ollewelin/delta_robot/README.md

3x3 Motor dirver board for a delta robot
Open Source

## 3x3Motor V2.0 with Efinix T20 FPGA 2 CSI camera ports and 8ch 12bit ADC with current shunt OP amplifier

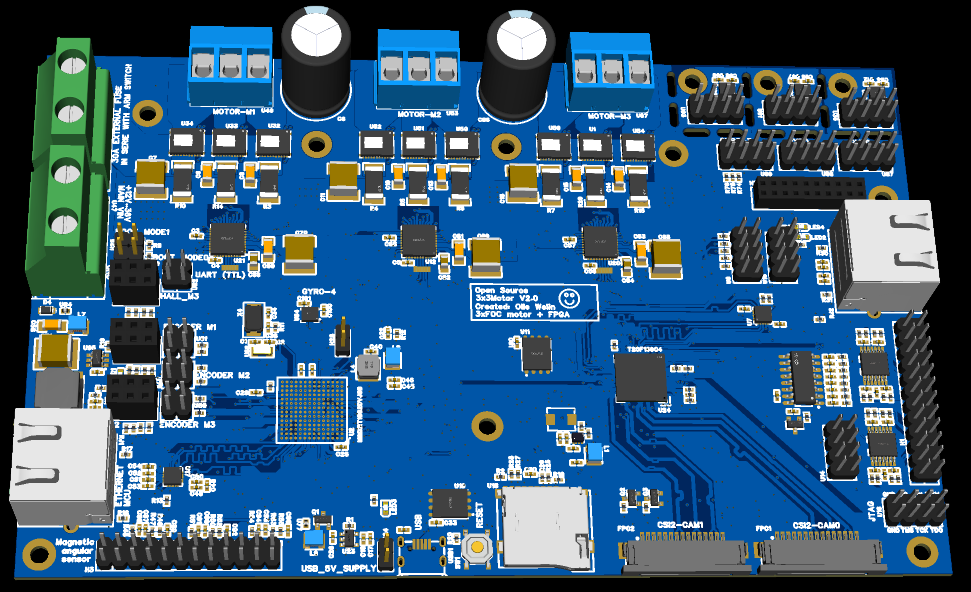
[picture p1: 3x3Motor_V2.0_FPGA_T20.png]


## 3x3Motor V1.0

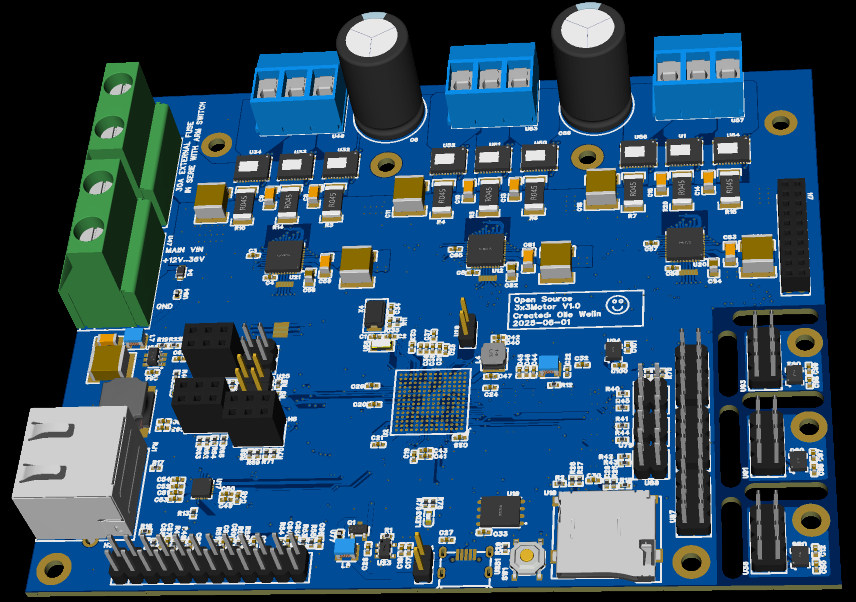
[picture p2: PCB_draft2.png]


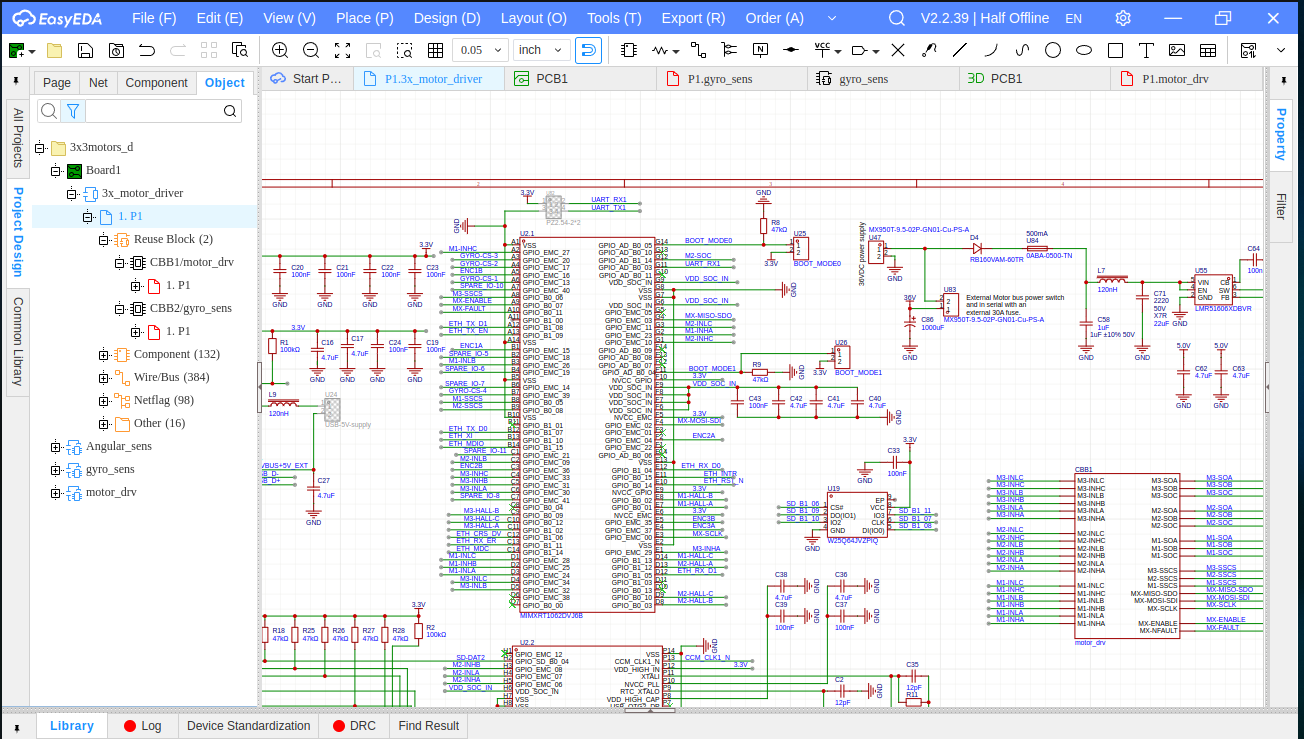
[picture p3: PCB_draft2_EasyEDA.png]
