ollewelin/delta_robot/Screenshot from 2025-05-25 20-46-30.png

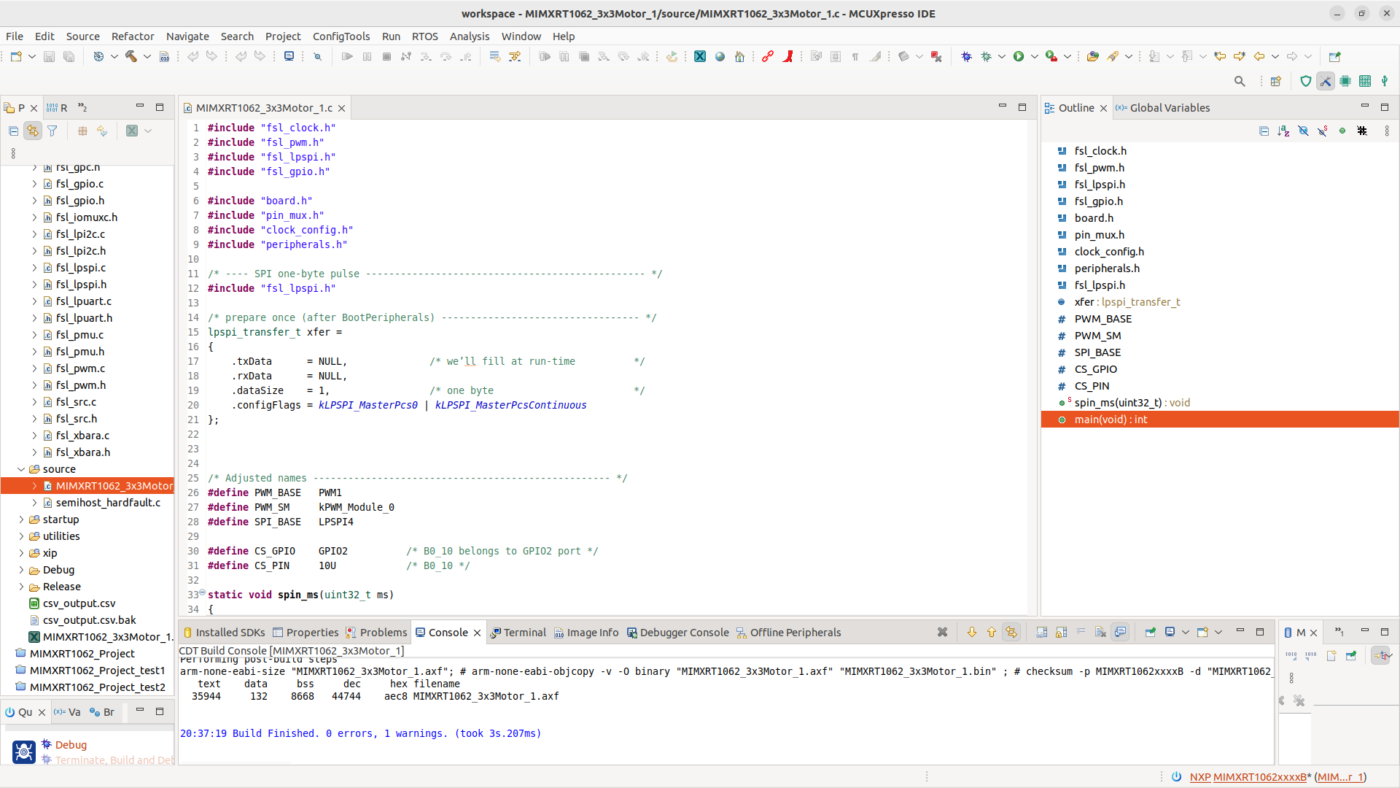
Screenshot from 2025-05-25 20-46-30.png
