ollewelin/delta_robot/Screenshot from 2025-05-25 20-46-59.png

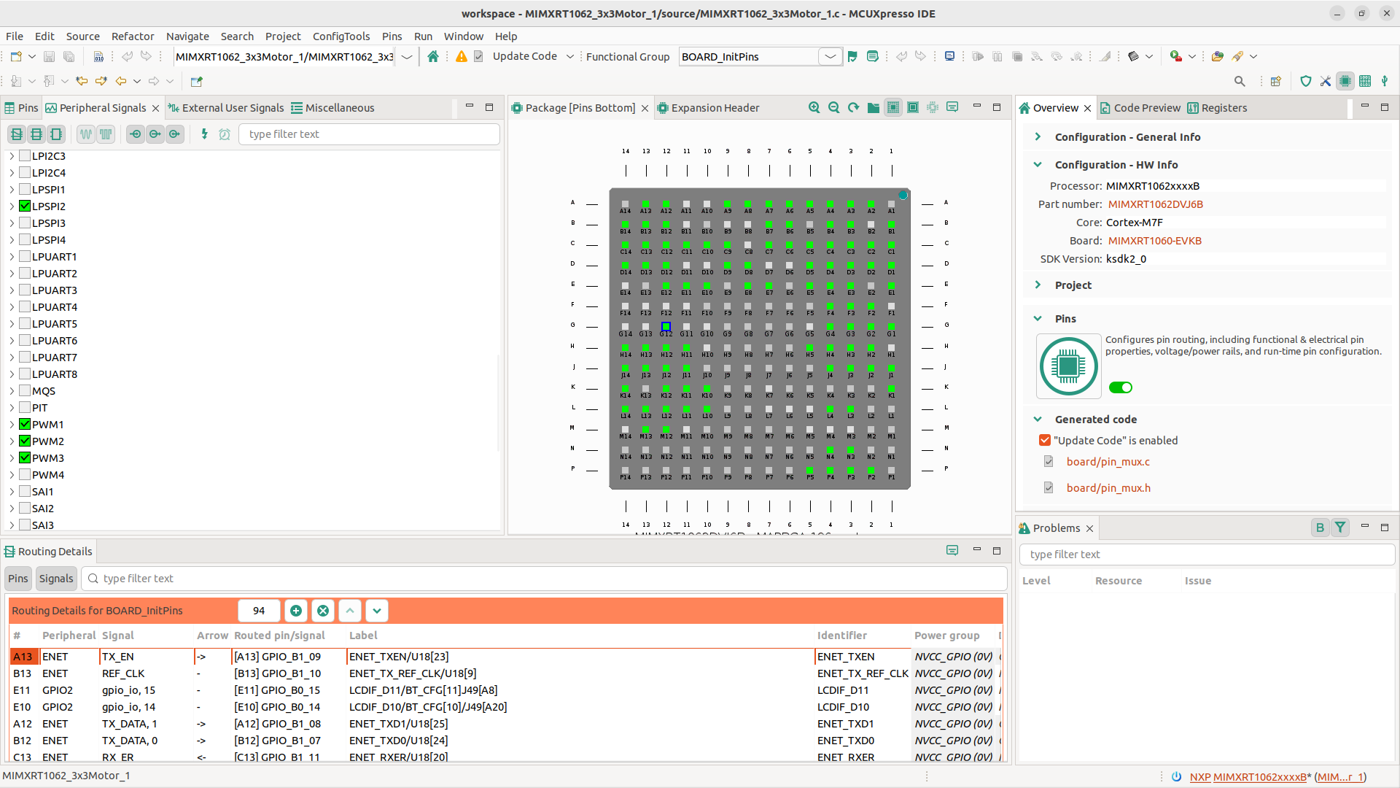
Screenshot from 2025-05-25 20-46-59.png
