ollewelin/delta_robot/V2.0_PCBA_manufacture_export/BOM_Board1_PCB1_2025-06-28_manuel_adjusted.xlsx

No. | Quantity | Comment | Designator | Footprint | Value | Manufacturer Part | Manufacturer | Supplier Part | Supplier
1 | 6 | 12pF | C1,C2,C34,C35,C109,C110 | C0402 | 12pF | V120J0402HQC500NBT | VIIYONG(微容) | C5251212 | LCSC
2 | 68 | 100nF | C3,C19,C20,C21,C22,C23,C24,C25,C26,C28,C30,C31,C32,C33,C37,C39,C43,C47,C50,C55,C57,C61,C64,C73,C74,C76,C78,C80,C85,C96,C100,C104,C111,C112,C113,C114,C116,C117,C118,C119,C120,C121,C122,C123,C124,C125,C126,C127,C128,C129,C130,C131,C133,C134,C137,C139,C141,C142,C143,C144,C145,C146,C148,C149,C150,C151,C152,C153 | C0402 | 100nF | CL05B104KB54PNC | SAMSUNG(三星) | C307331 | LCSC
3 | 38 | 4.7uF | C4,C5,C12,C16,C17,C27,C29,C36,C38,C40,C41,C42,C44,C45,C46,C48,C49,C56,C60,C62,C63,C65,C67,C72,C75,C77,C79,C97,C101,C102,C103,C115,C132,C135,C136,C138,C140,C147 | C0402 | 4.7uF | LMK105BBJ475MVLF | TAIYO YUDEN(太诱) | C386043 | LCSC
4 | 2 | 1000uF | C6,C86 | CAP-TH_BD13.0-P5.00-D0.6-FD | 1000uF | 50V1000uF CD288 | HRK(鸿瑞凯电子) | C2960425 | LCSC
5 | 7 | 22uF | C7,C11,C18,C68,C69,C70,C71 | C2220 | 22uF | FS55X226K500EHG | PSA(信昌电陶) | C784103 | LCSC
6 | 10 | 1uF | C8,C9,C10,C13,C14,C15,C58,C59,C81,C83 | C1206 | 1uF | CL31B105KBHNNNE | SAMSUNG(三星) | C1848 | LCSC
7 | 8 | 33nF | C51,C52,C53,C54,C105,C106,C107,C108 | C0402 | 33nF | 0402B333K160CT | Walsin(华新科) | C301939 | LCSC
8 | 3 | 22nF | C66,C82,C84 | C0805 | 22nF | CL21B223KBANNNC | SAMSUNG(三星) | C1729 | LCSC
9 | 9 | 4.7nF | C87,C88,C89,C90,C91,C92,C93,C94,C95 | C0402 | 4.7nF | 0402B472K500NT | FH(风华) | C1538 | LCSC
10 | 1 | RB160VAM-60TR | D4 | TUMD2M_L2.0-W1.4-LS2.5-RD |  | RB160VAM-60TR | ROHM(罗姆) | C600653 | LCSC
11 | 2 | 52271-1569 | FPC1,FPC2 | FFC-SMD_15P-P1.00_522711569 |  | 52271-1569 | MOLEX | C588183 | LCSC
12 | 1 | HX PZ2.54-2x12P ZZ | H1 | HDR-TH_24P-P2.54-V-M-R2-C12-S2.54 |  | HX PZ2.54-2x12P ZZ | hanxia(韩下) | C42372520 | LCSC
13 | 3 | 排母/2.54mm2x3直排母袋装环保 | H4,H5,H6 | HDR-TH_6P-P2.54-V-F-R2-C3-S2.54 |  | 排母/2.54mm2x3直排母袋装环保 |  | C47552 | LCSC
14 | 1 | 2.0-210-SMT-Pin | H7 | HDR-TH_20P-P2.00-V-F-R2-C10-S2.00 |  | 2.0-210-SMT-Pin |  | C9900188734 | LCSC
15 | 4 | PZ254-1-02-Z-8.5 | H24,H25,H26,H28 | HDR-TH_2P-P2.54-V-M |  | PZ254-1-02-Z-8.5 | HCTL(华灿天禄) | C2894925 | LCSC
16 | 4 | 120nH | L1,L7,L8,L9 | IND-SMD_L2.9-W2.5 | 120nH | LSF1008-R12J-T | EMTEK(兆欣) | C252036 | LCSC
17 | 1 | 4.7uH | L4 | IND-SMD_L4.0-W4.0 | 4.7uH | SNR4018-4R7MT | LanTu Micro(蓝图微电) | C5127371 | LCSC
18 | 1 | 33uH | L11 | IND-SMD_L8.0-W8.0 | 33uH | NRS8030T330MJGJ | TAIYO YUDEN(太诱) | C223028 | LCSC
19 | 4 | KT-0603R | LED1,LED2,LED3,LED4 | LED0603-RD |  | KT-0603R | KENTO | C2286 | LCSC
20 | 1 | DMG2305UX-7 | Q1 | SOT-23-3_L2.9-W1.3-P1.90-LS2.4-BR |  | DMG2305UX-7 | HXY MOSFET(华轩阳电子) | C5261054 | LCSC
21 | 2 | BSS138 | Q2,Q3 | SOT-23-3_L2.9-W1.3-P1.90-LS2.4-BR-1 |  | BSS138 | KUU | C3015220 | LCSC
22 | 3 | 100kΩ | R1,R2,R21 | R0402 | 100kΩ | FRC0402F1003TS | FOJAN(富捷) | C2906859 | LCSC
23 | 9 | 20mΩ | R3,R4,R5,R6,R7,R10,R14,R15,R20 | RES-SMD_L6.4-W3.2-R2512 | 20mΩ | PA2512FKF7W0R02E | YAGEO(国巨) | C728347 | LCSC
24 | 8 | 47kΩ | R8,R9,R18,R25,R26,R27,R28,R29 | R0402 | 47kΩ | AC0402JR-0747KL | YAGEO(国巨) | C144710 | LCSC
25 | 1 | 2.2MΩ | R11 | R0402 | 2.2MΩ | FRC0402F2204TS | FOJAN(富捷) | C2998080 | LCSC
26 | 16 | 1kΩ | R12,R40,R41,R42,R43,R44,R45,R57,R59,R61,R63,R65,R67,R69,R71,R73 | R0402 | 1kΩ | 0402WGF1001TCE | UNI-ROYAL(厚声) | C11702 | LCSC
27 | 2 | 6.49kΩ | R13,R24 | R0402 | 6.49kΩ | RT0402BRE076K49L | YAGEO(国巨) | C853380 | LCSC
28 | 4 | 150Ω | R16,R17,R30,R31 | R0402 | 150Ω | 0402WGF1500TCE | UNI-ROYAL(厚声) | C25082 | LCSC
29 | 1 | 20kΩ | R19 | R0402 | 20kΩ | 0402WGJ0203TCE | UNI-ROYAL(厚声) | C25545 | LCSC
30 | 34 | 4.7kΩ | R22,R23,R35,R36,R37,R38,R39,R46,R47,R48,R49,R50,R51,R52,R53,R54,R55,R56,R58,R60,R62,R64,R66,R68,R70,R72,R74,R75,R76,R83,R84,R85,R86,R88 | R0402 | 4.7kΩ | 0402WGF4701TCE | UNI-ROYAL(厚声) | C25900 | LCSC
31 | 21 | 470Ω | R33,R89,R90,R95,R96,R97,R98,R99,R100,R101,R102,R103,R104,R105,R106,R107,R108,R109,R110,R111,R119 | R0402 | 470Ω | 0402WGF4700TCE | UNI-ROYAL(厚声) | C25117 | LCSC
32 | 8 | 150Ω | R34,R112,R113,R114,R115,R116,R117,R118 | R0402 | 150Ω | CRCW0402150RFKED | VISHAY(威世) | C82683 | LCSC
33 | 13 | 22Ω | R77,R78,R80,R81,R91,R120,R121,R122,R123,R124,R125,R126,R127 | R0402 | 22Ω | ERJU02J220X | PANASONIC(松下) | C417075 | LCSC
34 | 3 | 10kΩ | R79,R82,R87 | R0402 | 10kΩ | 0402WGF1002TCE | UNI-ROYAL(厚声) | C25744 | LCSC
35 | 2 | RJHSE5384 | RJ1,RJ2 | RJ45-TH_RJHSE5384 |  | RJHSE5384 | Amphenol | C464587 | LCSC
36 | 1 | TS-1187A-B-A-B | SW1 | SW-SMD_4P-L5.1-W5.1-P3.70-LS6.5-TL_H1.5 |  | TS-1187A-B-A-B | XKB Connectivity(中国星坤) | C318884 | LCSC
37 | 9 | CSD88599Q5DC | U1,U32,U33,U34,U50,U51,U52,U54,U56 | SON-22_L5.0-W6.0-P0.50-CSD88599Q5DCT |  | CSD88599Q5DC | TI(德州仪器) | C2871380 | LCSC
38 | 1 | MIMXRT1062DVJ6B | U2 | LFBGA-196_L12.0-W12.0-R14-C14-P0.80-BL |  | MIMXRT1062DVJ6B | NXP(恩智浦) | C3216699 | LCSC
39 | 2 | INA4180A3QPWRQ1 | U3,U25 | TSSOP-14_L5.0-W4.4-P0.65-LS6.4-BL |  | INA4180A3QPWRQ1 | TI(德州仪器) | C2866762 | LCSC
40 | 1 | LM4040EEM3-2.5/NOPB | U4 | SOT-23-3_L2.9-W1.3-P1.90-LS2.4-BR |  | LM4040EEM3-2.5/NOPB | TI(德州仪器) | C205908 | LCSC
41 | 1 | MCP3208T-CI/SL | U5 | SOIC-16_L9.9-W3.9-P1.27-LS6.0-BL |  | MCP3208T-CI/SL | MICROCHIP(美国微芯) | C626764 | LCSC
42 | 9 | PZ2.54-2*4 | U6,U14,U15,U16,U35,U87,U88,U89,U91 | HDR-TH_8P-P2.54-V-M-R2-C4-S2.54 |  | PZ2.54-2*4 | ZHOURI(洲日) | C5156676 | LCSC
43 | 2 | DP83825IRMQR | U7,U17 | HVQFN-24_L3.0-W3.0-P0.40-TL-EP1.9 |  | DP83825IRMQR | TI(德州仪器) | C783599 | LCSC
44 | 1 | TPS62840DLCR | U9 | VSON-8_L2.0-W1.5-P0.50-BL |  | TPS62840DLCR | TI(德州仪器) | C2071859 | LCSC
45 | 1 | 2.2uH | U10 | IND-SMD_L4.7-W4.2 | 2.2uH | CYA0420-2.2UH | SHOU HAN(首韩) | C19274348 | LCSC
46 | 2 | W25Q64JVZPIQ | U11,U19 | WSON-8_L6.0-W5.0-P1.27-BL-EP |  | W25Q64JVZPIQ | WINBOND(华邦) | C2940197 | LCSC
47 | 3 | DRV8304SRHAR | U12,U20,U21 | VQFN-40_L6.0-W6.0-P0.50-TL-EP |  | DRV8304SRHAR | TI(德州仪器) | C1849480 | LCSC
48 | 1 | PCA9306DC1 | U13 | VSSOP-8_L2.4-W2.1-P0.50-LS3.2-BR |  | PCA9306DC1 | NXP(恩智浦) | C129510 | LCSC
49 | 1 | A-MicroTF-1.85A | U18 | TF-SMD_A-MICROTF-1.85A |  | A-MicroTF-1.85A | MyAntenna(摩天射频) | C22467599 | LCSC
50 | 1 | TLV75525PDQNR | U22 | X2SON-4_L1.0-W1.0-P0.65-TL-EP |  | TLV75525PDQNR | TI(德州仪器) | C2876066 | LCSC
51 | 1 | TLV75733PDBVR | U23 | SOT-23-5_L2.9-W1.6-P0.95-LS2.8-BL |  | TLV75733PDBVR | TI(德州仪器) | C485517 | LCSC
52 | 1 | T20F169C4 | U24 | FBGA-169_L9.0-W9.0-R13-C13-P0.65-TL |  | T20F169C4 | Efinix | C7054906 | LCSC
53 | 1 | PCA9542APW/DG118 | U26 | TSSOP-14_L4.9-W4.4-P0.65-LS6.4-BL |  | PCA9542APW/DG118 | NXP(恩智浦) | C3208518 | LCSC
54 | 1 | TLV75512PDBVR | U27 | SOT-23-5_L2.9-W1.6-P0.95-LS2.8-BR |  | TLV75512PDBVR | TI(德州仪器) | C2877864 | LCSC
55 | 1 | TLV75518PDBVR | U31 | SOT-23-5_L2.9-W1.6-P0.95-LS2.8-BR |  | TLV75518PDBVR | TI(德州仪器) | C2877863 | LCSC
56 | 2 | MX950T-9.5-02P-GN01-Cu-PS-A | U47,U83 | CONN-TH_2P-P9.50_DB910-9.52-2P |  | MX950T-9.5-02P-GN01-Cu-PS-A | MAX(迈旭) | C5188495 | LCSC
57 | 3 | KF332K-5.0-3P | U49,U53,U57 | CONN-TH_KF332K-5.0-3P |  | KF332K-5.0-3P | KEFA(科发) | C474890 | LCSC
58 | 1 | 32.768kHz | U66 | CRYSTAL-SMD_L3.2-W1.5-2 | 32.768kHz | H3100327092070CY | JGHC(晶光华) | C20625736 | LCSC
59 | 2 | 0ABA-0500-TN | U77,U84 | F0402 |  | 0ABA-0500-TN | belfuse | C3162379 | LCSC
60 | 4 | PZ2.54-2*2 | U79,U80,U81,U82 | HDR-TH_4P-P2.54-V-M-R2-C2-S2.54 |  | PZ2.54-2*2 | ZHOURI(洲日) | C5156675 | LCSC
61 | 3 | ASM330LHHTR | U86,U90,U94 | LGA-14L_L3.0-W2.5-P0.50-TL |  | ASM330LHHTR | ST(意法半导体) | C459826 | LCSC
62 | 1 | LMR51610XDBVR | U95 | SOT-23-6_L2.9-W1.6-P0.95-LS2.8-BR |  | LMR51610XDBVR | TI(德州仪器) | C20539658 | LCSC
63 | 1 | 051N-4BH806-S | USB1 | MICRO-USB-SMD_051N-4BH806-S |  | 051N-4BH806-S | HanElectricity(瀚源) | C25503148 | LCSC
64 | 1 | 25MHz | X1 | CRYSTAL-SMD_4P-L5.0-W3.2-BL | 25MHz | XC53M4-25.000-F12JJDT | HCI(杭晶) | C2916916 | LCSC
65 | 1 | 24MHz | X4 | OSC-SMD_L5.0-W3.2 | 24MHz | XSHEELNANF-24MHZ | TAITIEN(泰艺电子) | C295068 | LCSC
66 | 1 | 50MHz | X5 | OSC-SMD_4P-L3.2-W2.5-BL-OXETDLJANF-0.032768MHZ | 50MHz | 2.1.3.5000023 | MDH(明德亨) | C42420976 | LCSC
