ollewelin/delta_robot/failure_start_RAM_at_blank_MIMXRT1062/Log_test_evkbmimxrt1060_iled_blinky_iled_blinky.txt

Test the
evkbmimxrt1060_iled_blinky_iled_blinky.bin

Commands I test was this:
# Power cycle

sdphost -u 0x1fc9,0x0135 -- write-file 0x20000000 evkbmimxrt1060_iled_blinky_iled_blinky.bin
hexdump -C evkbmimxrt1060_iled_blinky_iled_blinky.bin
sdphost -u 0x1fc9,0x0135 -- read-register 0x20000000 8 13496 -h

# Manual reset

sdphost -u 0x1fc9,0x0135 -- error-status
sdphost -u 0x1fc9,0x0135 -- read-register 0x20000000
sdphost -u 0x1fc9,0x0135 -- jump-address 0x20000000
sdphost -u 0x1fc9,0x0135 -- error-status
sdphost -u 0x1fc9,0x0135 -- read-register 0x20000000 8 13496 -h

========== Log ==============
At line 1729 in this log I got this error
sdphost -u 0x1fc9,0x0135 -- error-status
Status (HAB mode) = 1450735702 (0x56787856) Hab Is Disabled (Unlocked).
Response status = 858993459 (0x33333333) NO DESCRIPTION.

(base) olle@olle-SSD-256:~/nxp_flashloader/mcu-boot-utility/tools/sdphost/linux/amd64$ sdphost -u 0x1fc9,0x0135 -- write-file 0x20000000 evkbmimxrt1060_iled_blinky_iled_blinky.bin
Status (HAB mode) = 1450735702 (0x56787856) Hab Is Disabled (Unlocked).
Response status = 2290649224 (0x88888888) Write File Success.
(base) olle@olle-SSD-256:~/nxp_flashloader/mcu-boot-utility/tools/sdphost/linux/amd64$ hexdump -C evkbmimxrt1060_iled_blinky_iled_blinky.bin
00000000  00 00 02 20 1d 03 00 20  a1 03 00 20 59 2a 00 20  |... ... ... Y*. |
00000010  a5 03 00 20 a7 03 00 20  a9 03 00 20 00 00 00 00  |... ... ... ....|
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
000034B0: 72 00 77 00 00 A4 78 1F                           r.w...x.
Status (HAB mode) = 1450735702 (0x56787856) Hab Is Disabled (Unlocked).
(base) olle@olle-SSD-256:~/nxp_flashloader/mcu-boot-utility/tools/sdphost/linux/amd64$
