ollewelin/delta_robot/V2.0_PCBA_manufacture_export/3x3Motor_V2.0_schematics.pdf

GPIO_B0_03 D8 GPIO_B0_00 D7 GPIO_EMC_38 D6 GPIO_EMC_32 D5 GPIO_EMC_34 D4 GPIO_EMC_24 D3 GPIO_EMC_25 D2 GPIO_EMC_28 D1 GPIO_B1_14 C14 GPIO_B1_11 C13 GPIO_B1_06 C12 GPIO_B1_02 C11 GPIO_B0_12 C10 GPIO_B0_09 C9 GPIO_B0_04 C8 GPIO_EMC_41 C7 GPIO_EMC_30 C6 GPIO_EMC_31 C5 GPIO_EMC_33 C4 GPIO_EMC_36 C3 GPIO_EMC_09 C2 GPIO_EMC_21 C1 GPIO_B1_15 B14 GPIO_B1_10 B13 GPIO_B1_07 B12 GPIO_B1_01 B11 VSS B10 GPIO_B0_08 B9 GPIO_B0_05 B8 GPIO_EMC_39 B7 GPIO_EMC_14 B6 VSS B5 GPIO_EMC_19 B4 GPIO_EMC_26 B3 GPIO_EMC_18 B2 GPIO_EMC_15 B1 VSS A14 GPIO_B1_09 A13 GPIO_B1_08 A12 GPIO_B1_00 A11 GPIO_B0_11 A10 GPIO_B0_07 A9 GPIO_B0_06 A8 GPIO_EMC_40 A7 GPIO_EMC_13 A6 GPIO_EMC_16 A5 GPIO_EMC_17 A4 GPIO_EMC_20 A3 GPIO_EMC_27 A2 VSS A1

# 3x3Motor V2.0 R⁴⁰ 1k

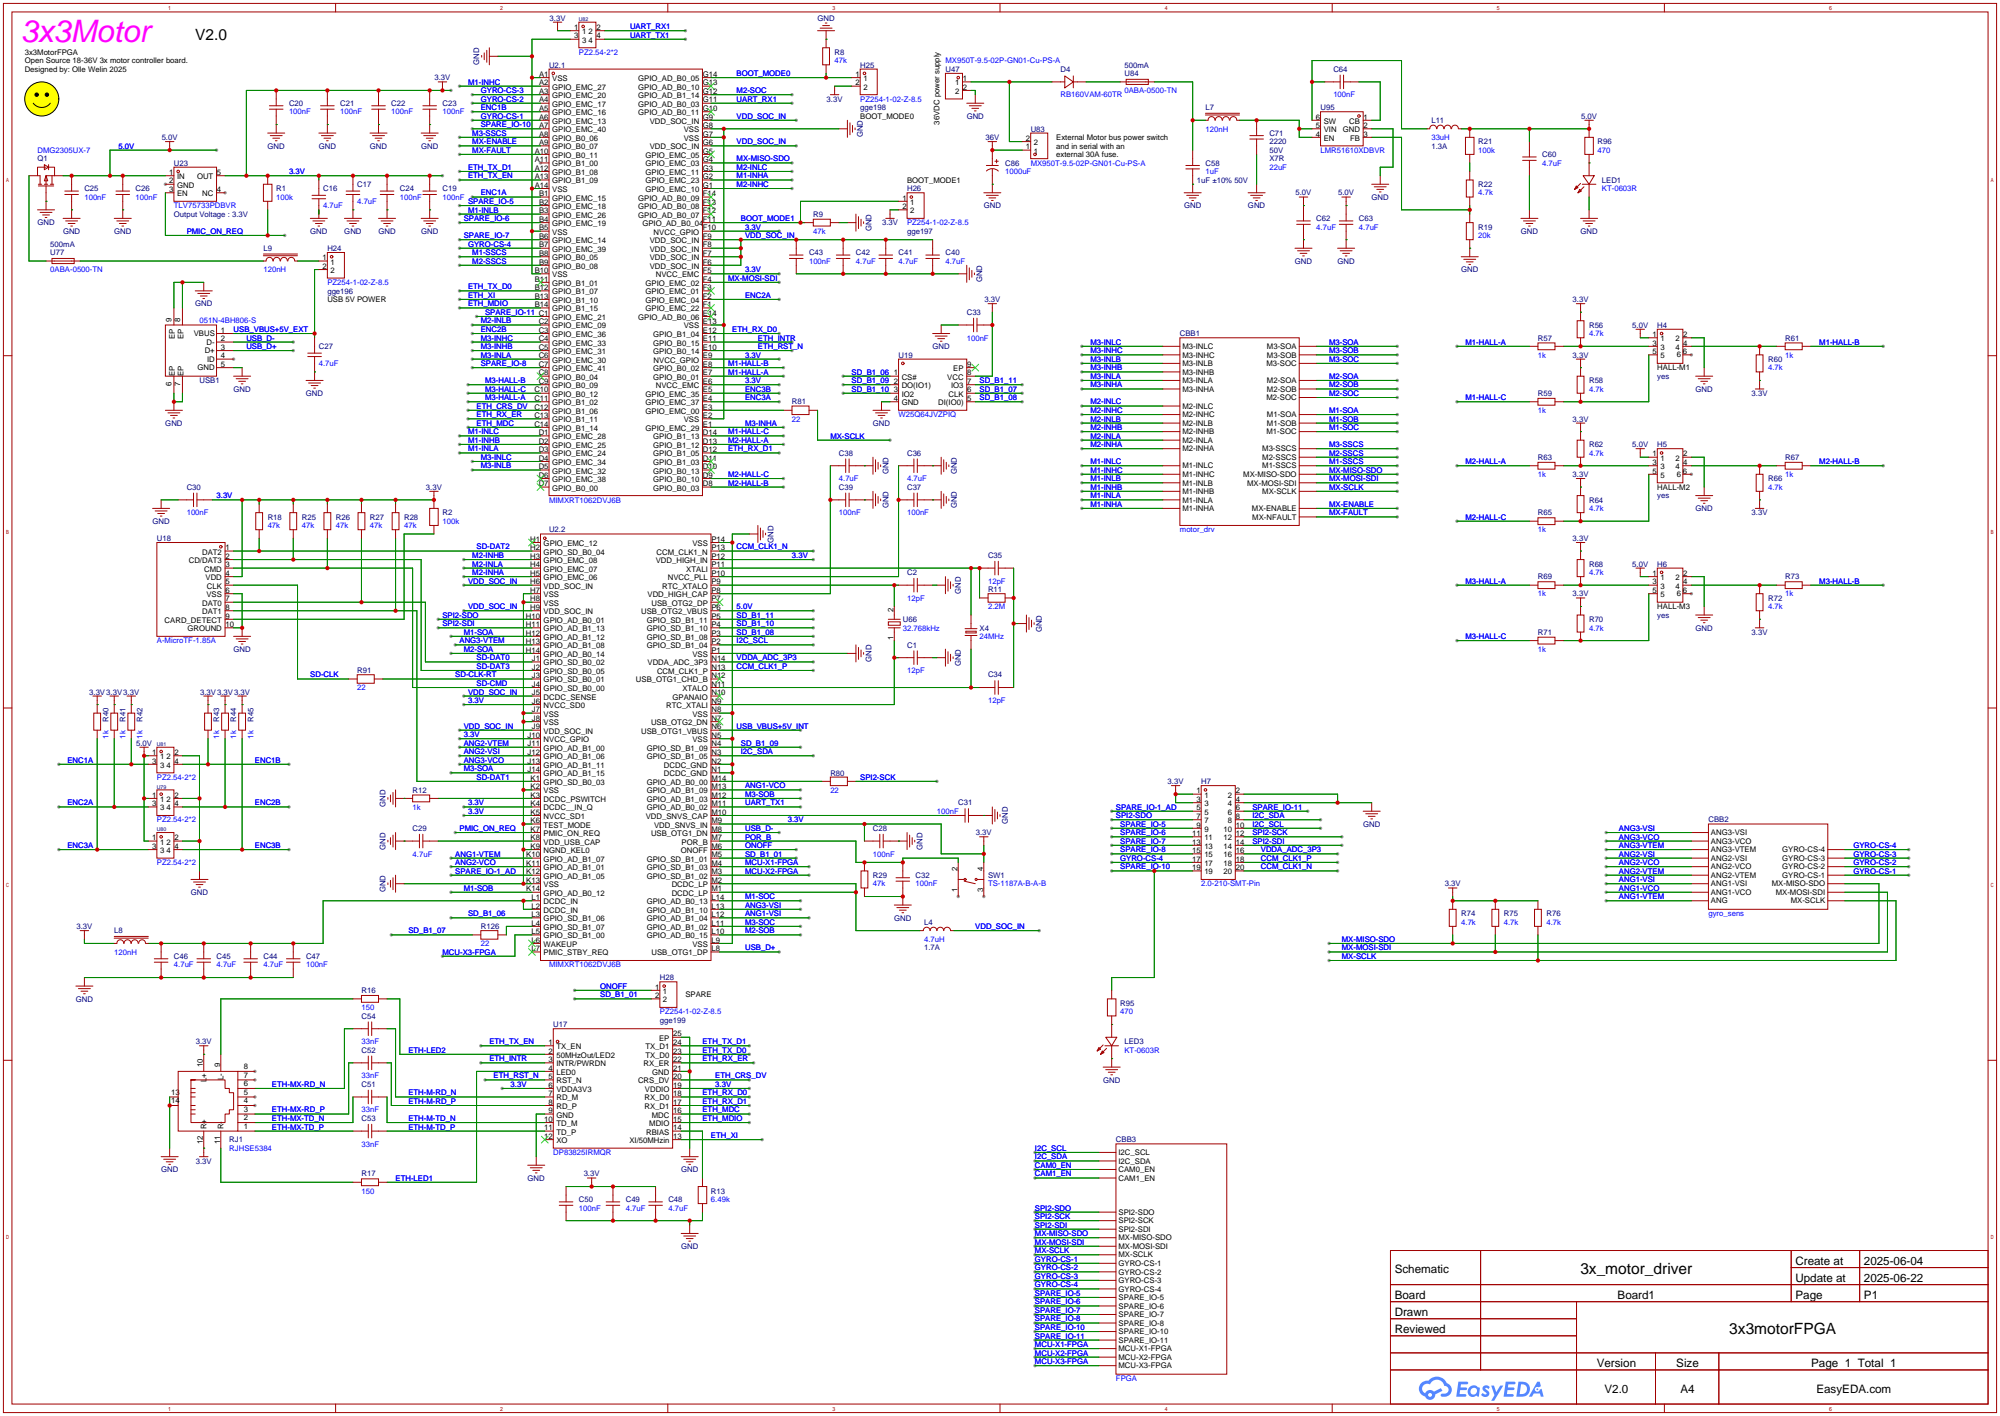
[picture p11: page 1]

3x3MotorFPGA
Open Source 18-36V 3x motor controller board.
Designed by: Olle Welin 2025

GND
USB_OTG1_DP L8 PMIC_STBY_REQ L7 WAKEUP L6 GPIO_SD_B1_00 L5 GPIO_SD_B1_07 L4 GPIO_SD_B1_06 L3 DCDC_IN L2 DCDC_IN L1 GPIO_AD_B0_12 K14 VSS K13 GPIO_AD_B1_05 K12 GPIO_AD_B1_01 K11 GPIO_AD_B1_07 K10 NGND_KEL0 K9 VDD_USB_CAP K8 PMIC_ON_REQ K7 TEST_MODE K6 NVCC_SD1 K5 DCDC__IN_Q K4 DCDC_PSWITCH K3 VSS K2 GPIO_SD_B0_03 K1 GPIO_AD_B1_15 J14 GPIO_AD_B1_11 J13 GPIO_AD_B1_06 J12 GPIO_AD_B1_00 J11 NVCC_GPIO J10 VDD_SOC_IN J9 VSS J8 VSS J7 NVCC_SD0 J6 DCDC_SENSE J5 GPIO_SD_B0_00 J4 GPIO_SD_B0_01 J3 GPIO_SD_B0_05 J2 GPIO_SD_B0_02 J1 GPIO_AD_B0_14 H14 GPIO_AD_B1_08 H13 GPIO_AD_B1_12 H12 GPIO_AD_B1_13 H11 GPIO_AD_B0_01 H10 VDD_SOC_IN H9 VSS H8 VSS H7 VDD_SOC_IN H6 GPIO_EMC_06 H5 GPIO_EMC_07 H4 GPIO_EMC_08 H3 GPIO_SD_B0_04 H2 GPIO_EMC_12 H1

Schematic | 3x_motor_driver | Create at | 2025-06-04

Update at | 2025-06-22

Board | Board1 | Page | P1
Drawn | | 3x3motorFPGA
Reviewed

Version | Size | Page 1 Total 1
V2.0 | A4 | EasyEDA.com

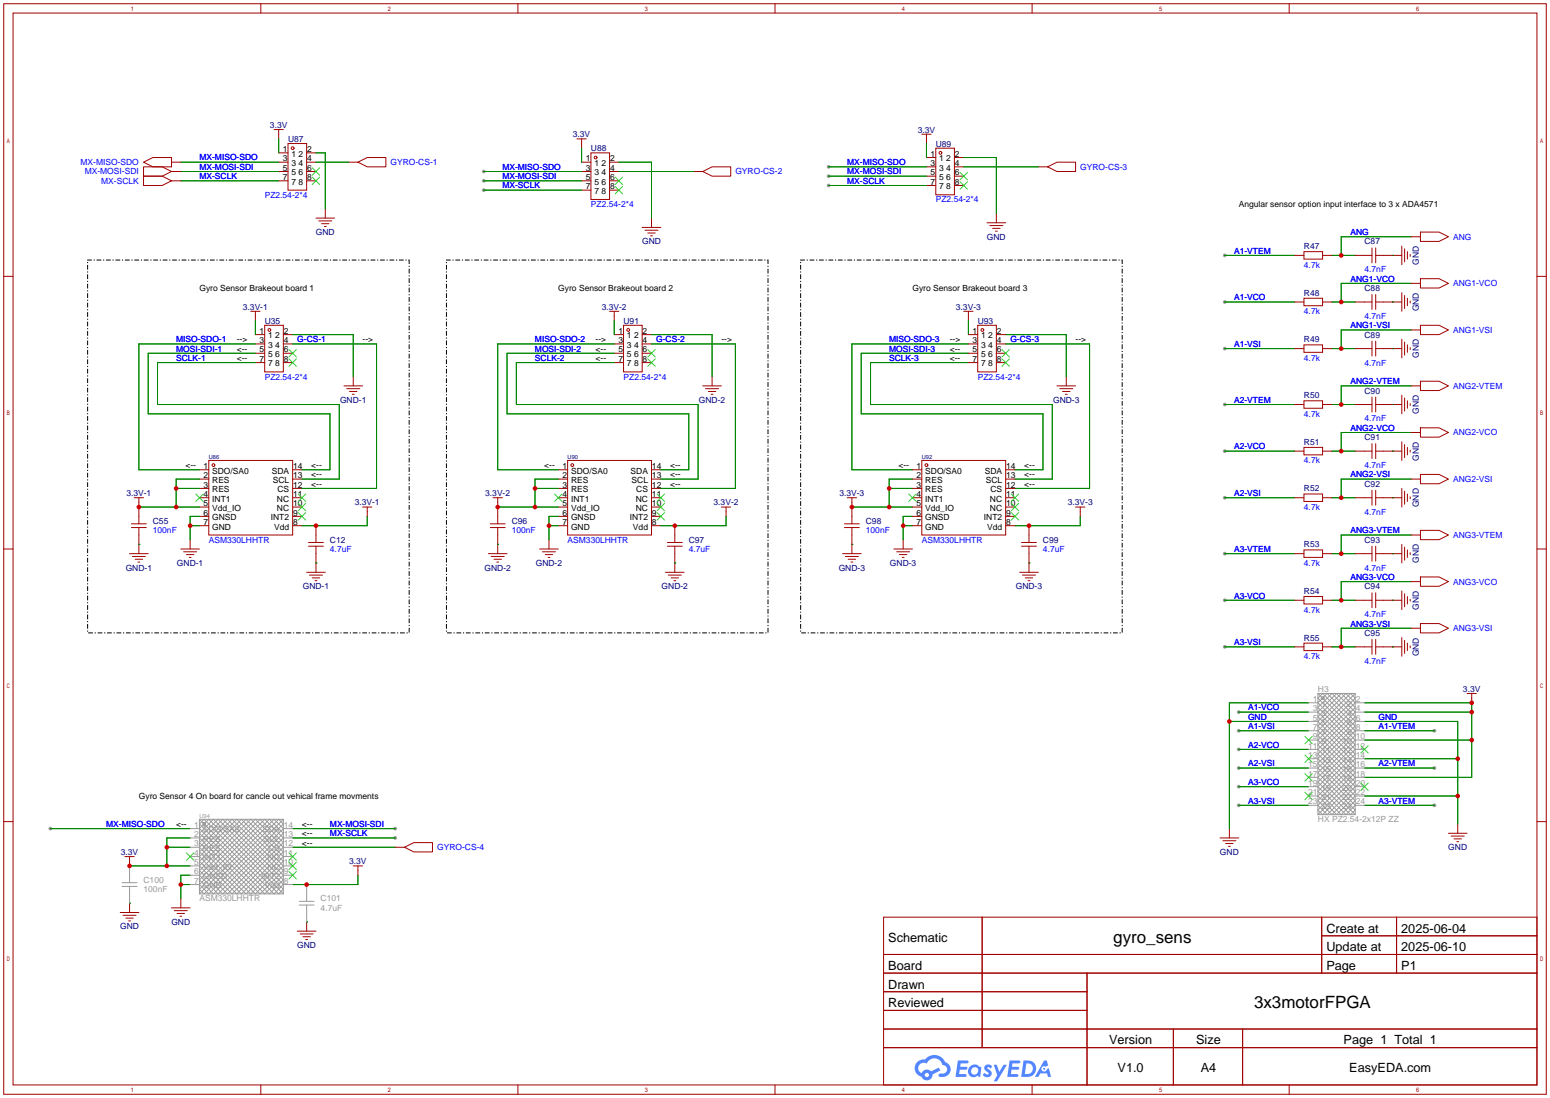
[picture p12: page 2]

Angular sensor option input interface to 3 x ADA4571

Gyro Sensor Brakeout board 1

Gyro Sensor Brakeout board 2

Gyro Sensor Brakeout board 3

NC 10 NC 11 CS 12 SCL 13 SDA 14

Gyro Sensor 4 On board for cancle out vehical frame movments

Schematic | gyro_sens | Create at | 2025-06-04

Update at | 2025-06-10

Board | | Page | P1
Drawn | | 3x3motorFPGA
Reviewed

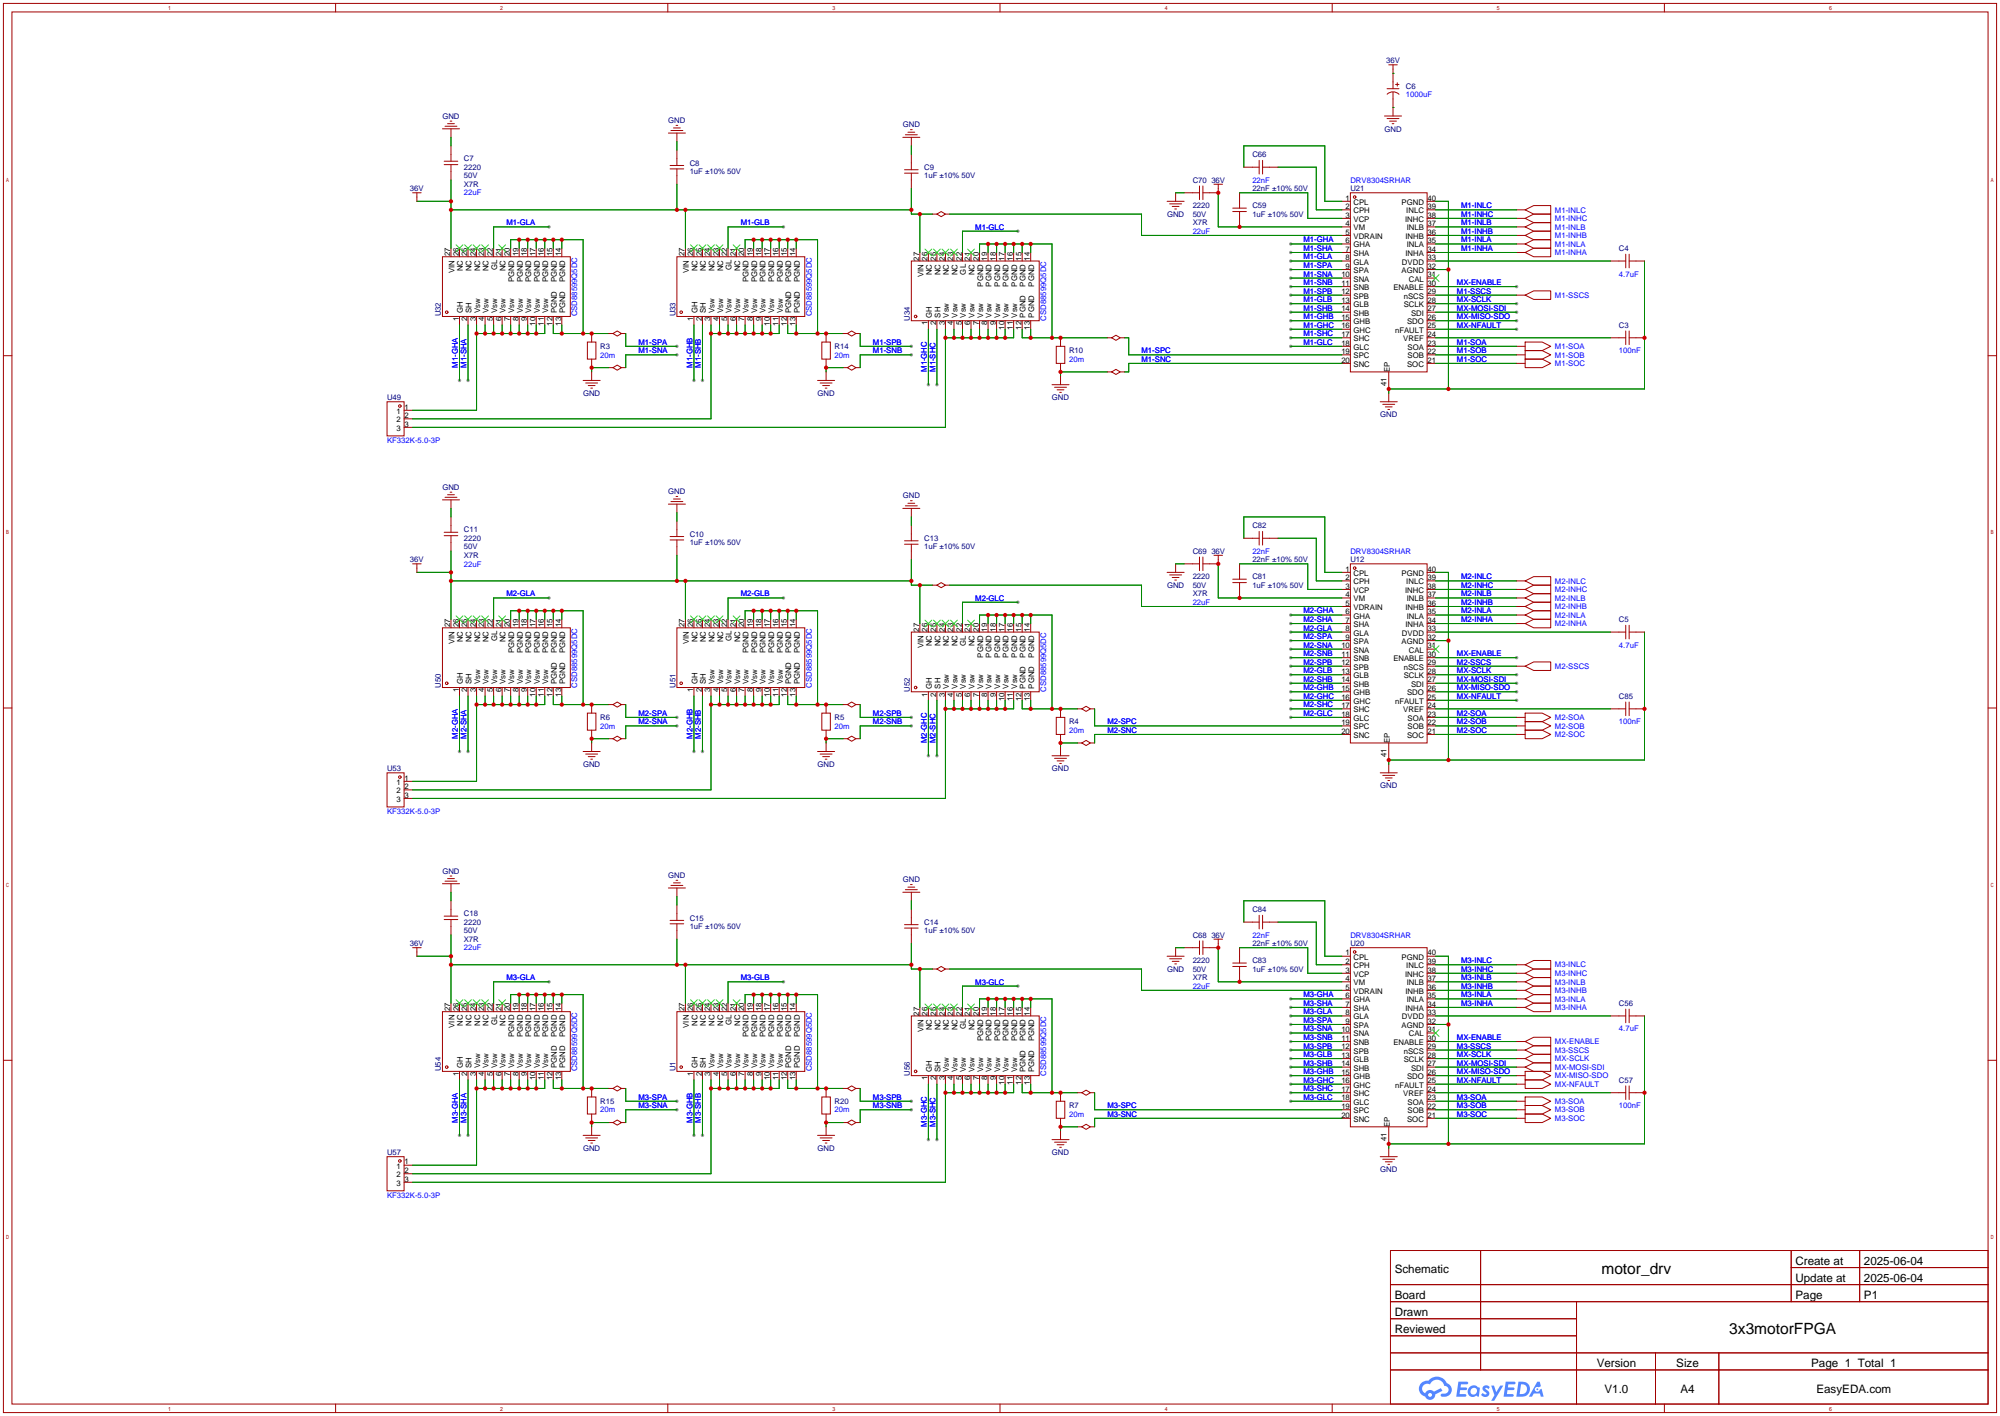
[picture p13: page 3]

PGND 13 PGND 14 PGND 15 PGND 16 PGND 17 PGND 18 PGND 19 PGND 20 NC 21 GL 22 NC 23 NC 24 NC 25 NC 26 VIN 27

Schematic | motor_drv | Create at | 2025-06-04

Update at | 2025-06-04

Board | | Page | P1

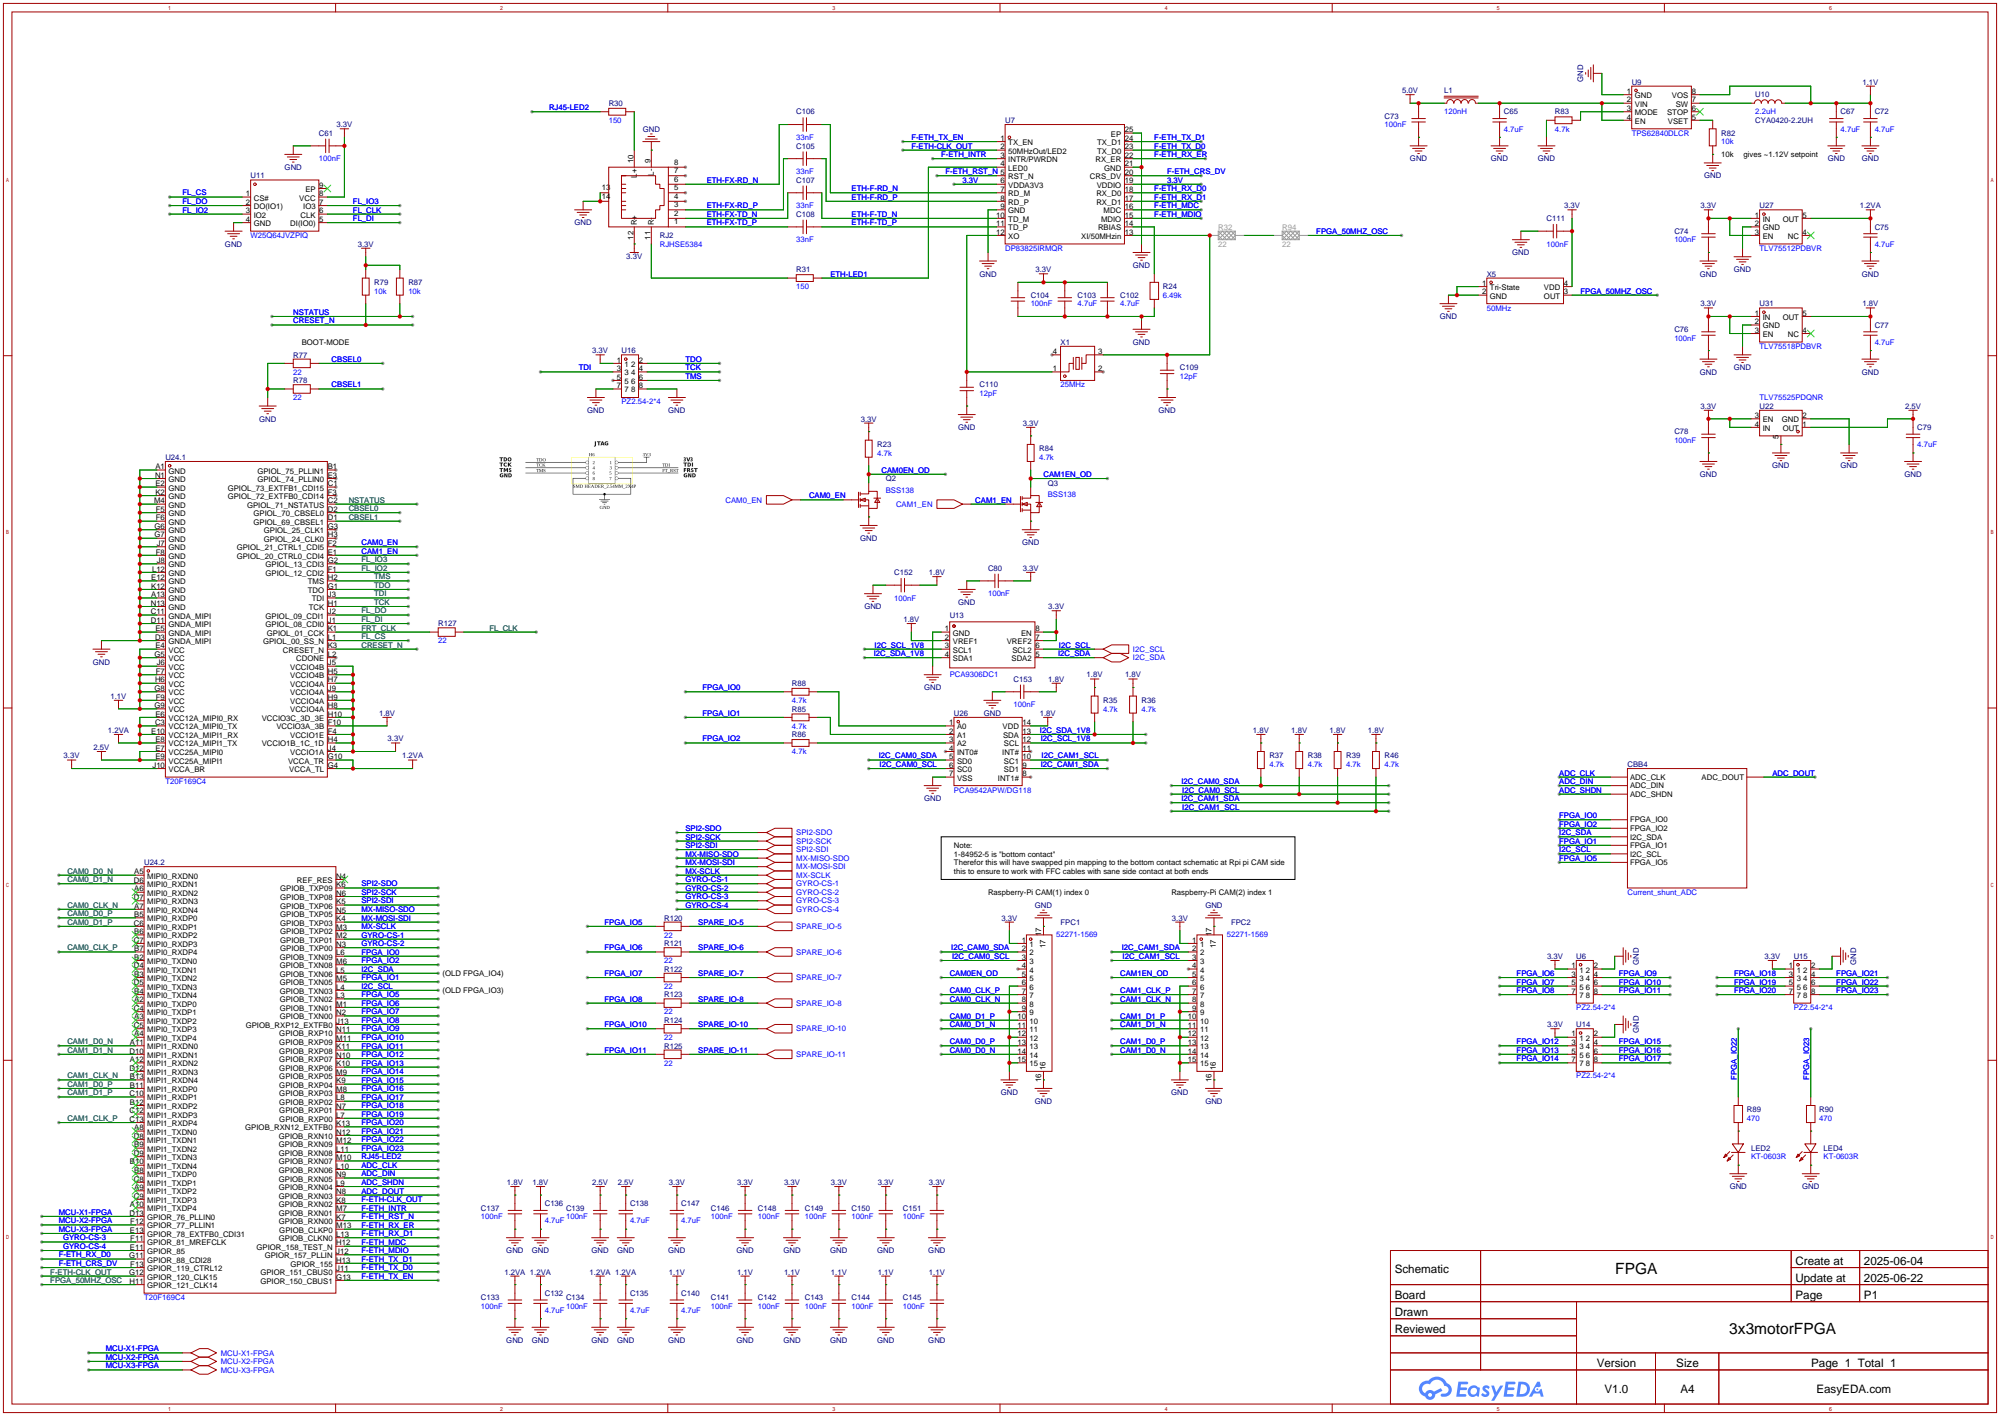
[picture p14: page 4]

GND
SC1 10 INT# 11 SCL 12 SDA 13 VDD 14

Note:
1-84952-5 is "bottom contact"
Therefor this will have swapped pin mapping to the bottom contact schematic at Rpi pi CAM side
this to ensure to work with FFC cables with sane side contact at both ends

Raspberry-Pi CAM(1) index 0

Raspberry-Pi CAM(2) index 1

Schematic | FPGA | Create at | 2025-06-04

Update at | 2025-06-22

Board | | Page | P1

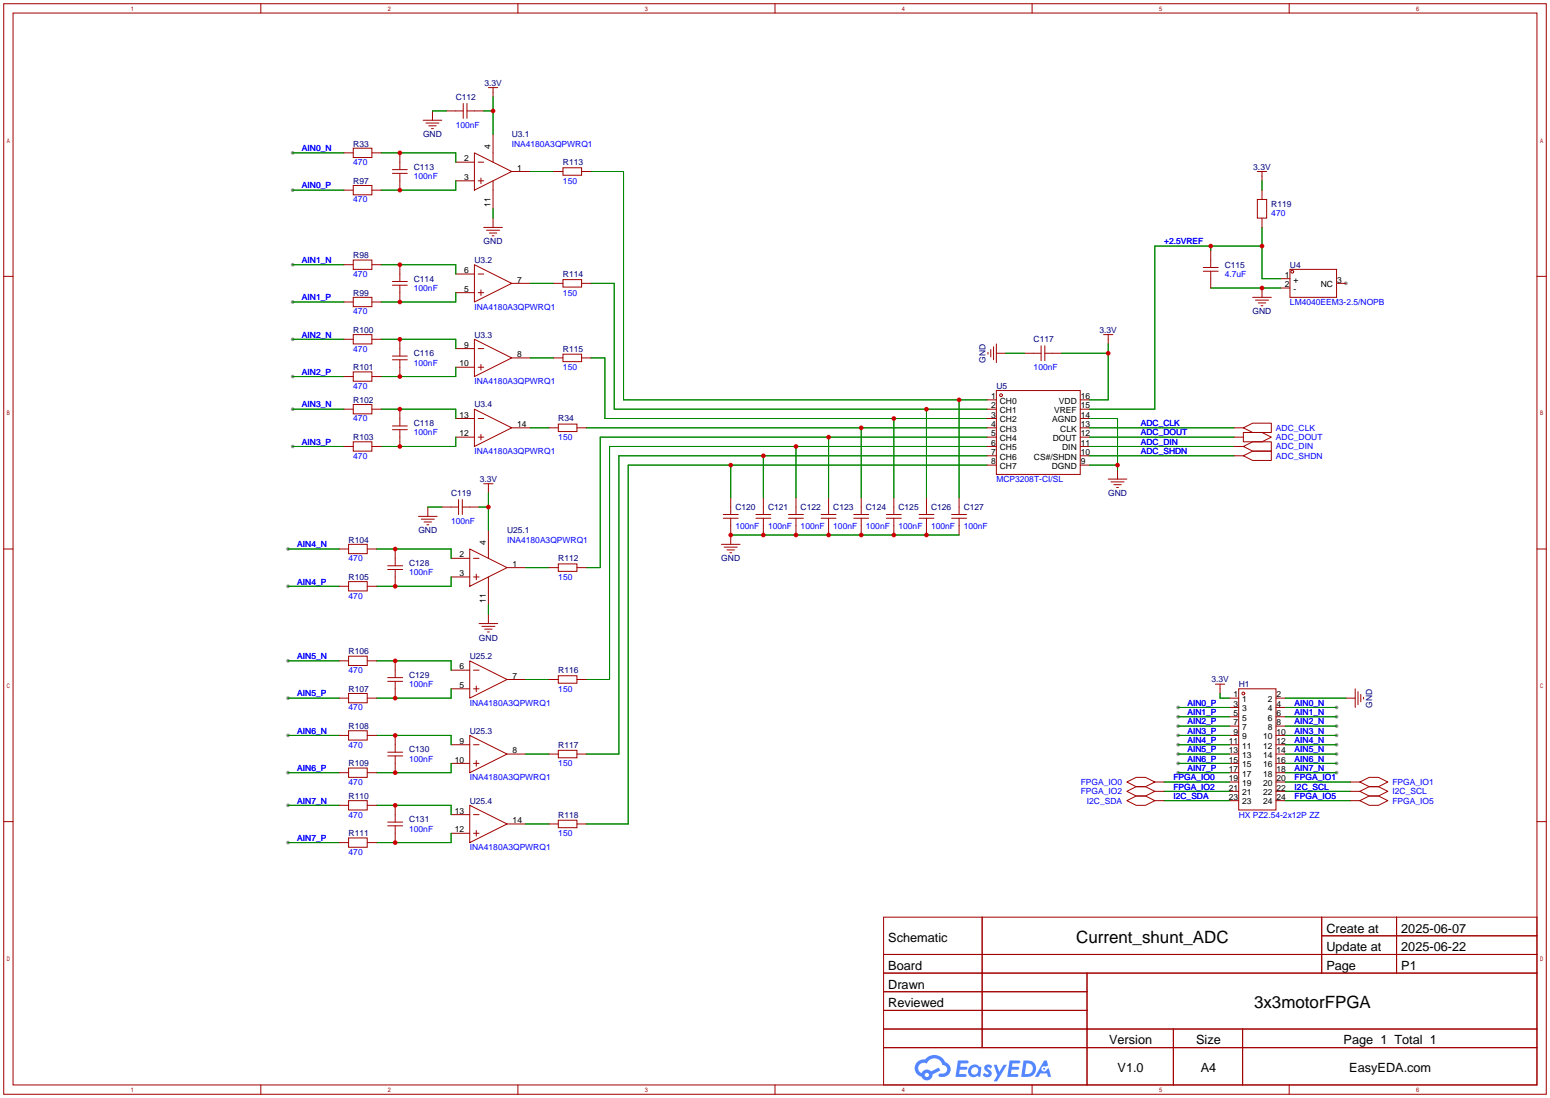
[picture p15: page 5]

CS#/SHDN 10 DIN 11 DOUT 12 CLK 13 AGND 14 VREF 15 VDD 16

Schematic | Current_shunt_ADC | Create at | 2025-06-07

Update at | 2025-06-22

Board | | Page | P1
Drawn | | 3x3motorFPGA
Reviewed
