ollewelin/delta_robot/FPGA_3x3Motor_DC_motors_MIPI_cameras_2025-12-20.pdf

# 3x3Motor FPGA EcoFlexAI. Delta arm sorting robot

V3.0

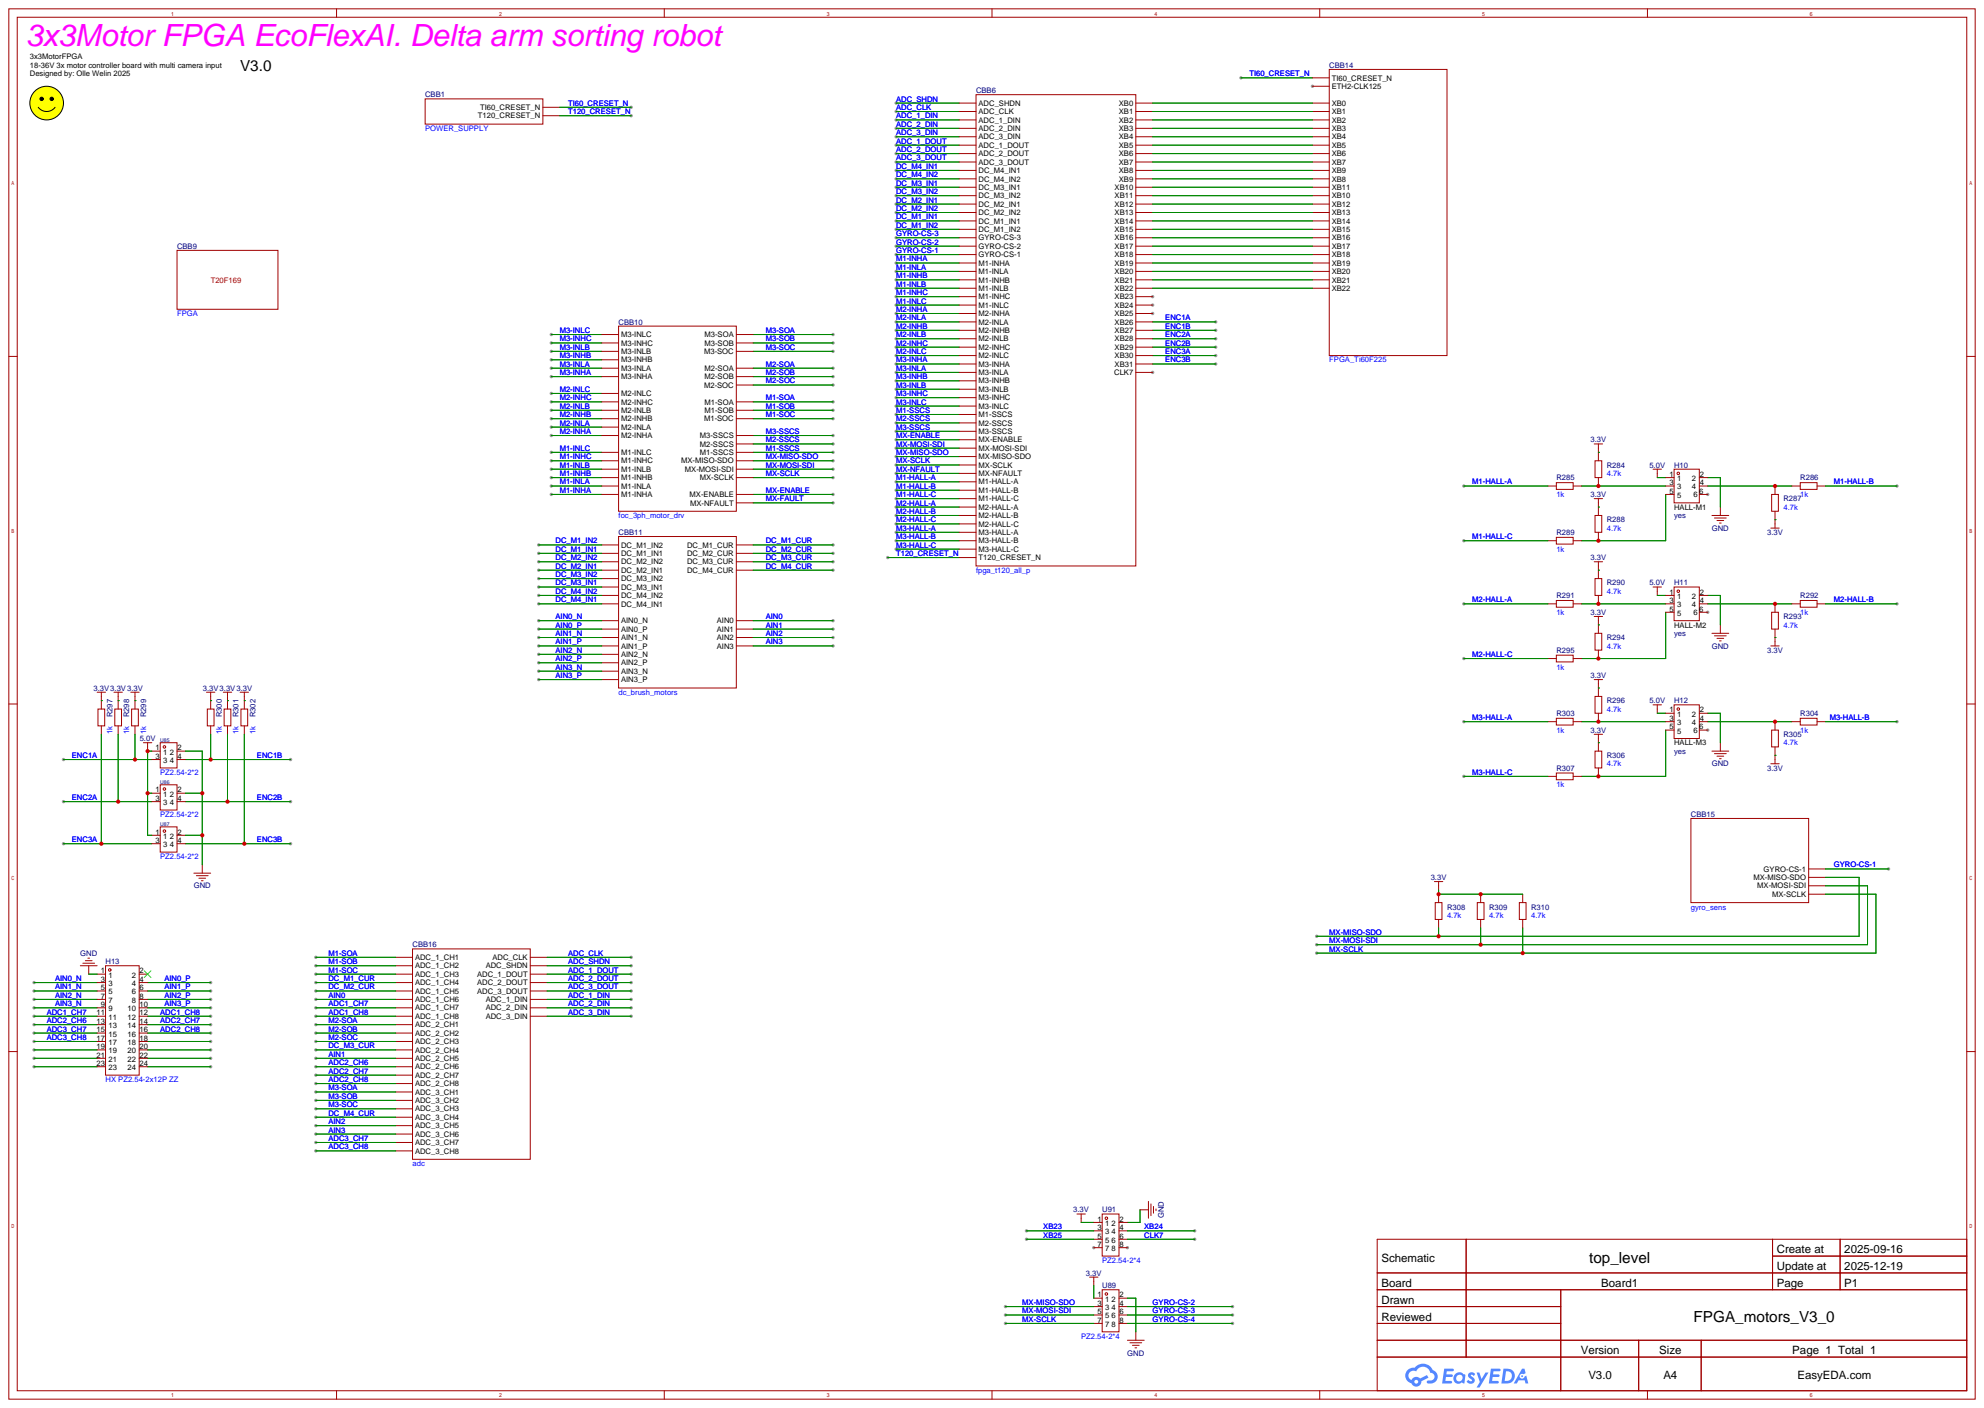
[picture p16: page 1]

3x3MotorFPGA
18-36V 3x motor controller board with multi camera input
Designed by: Olle Welin 2025

Schematic | top_level | Create at | 2025-09-16

Update at | 2025-12-19

Board | Board1 | Page | P1
Drawn | | FPGA_motors_V3_0
Reviewed

Version | Size | Page 1 Total 1
V3.0 | A4 | EasyEDA.com

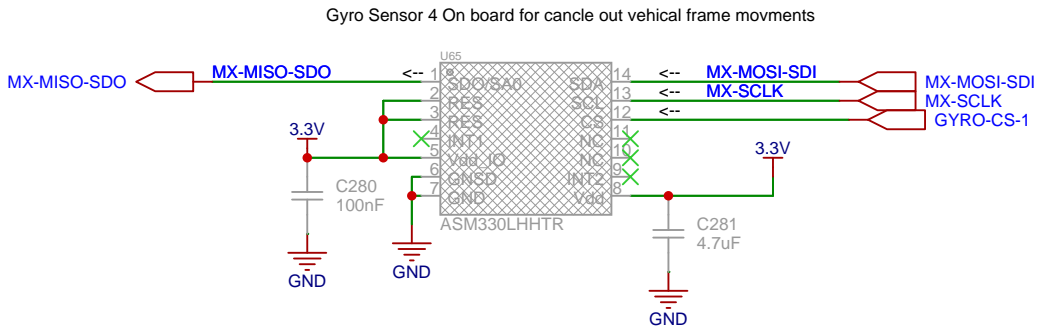
[picture p17: page 2]

Gyro Sensor 4 On board for cancle out vehical frame movments

NC 10 NC 11 CS 12 SCL 13 SDA 14

Schematic | gyro_sens | Create at | 2025-09-16

Update at | 2025-12-14

Board | | Page | P1
Drawn | | FPGA_motors_V3_0
Reviewed

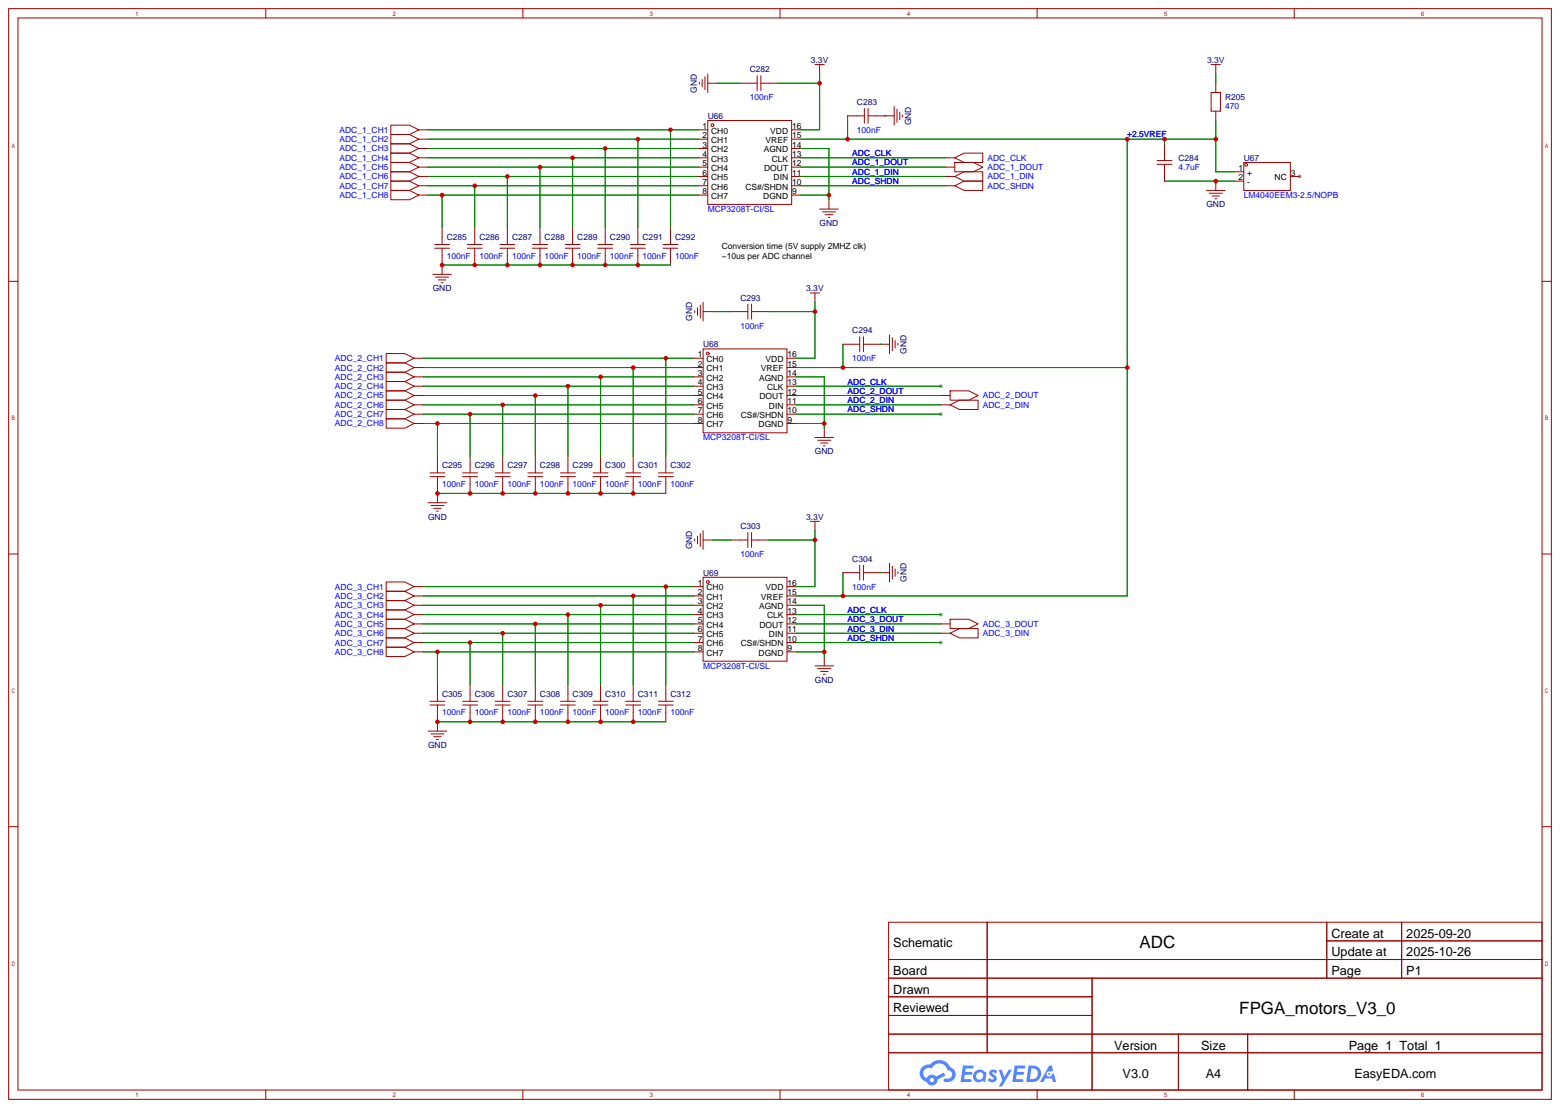
[picture p18: page 3]

CS#/SHDN 10 DIN 11 DOUT 12 CLK 13 AGND 14 VREF 15 VDD 16

Conversion time (5V supply 2MHZ clk)
~10us per ADC channel

Schematic | ADC | Create at | 2025-09-20

Update at | 2025-10-26

Board | | Page | P1
Drawn | | FPGA_motors_V3_0
Reviewed

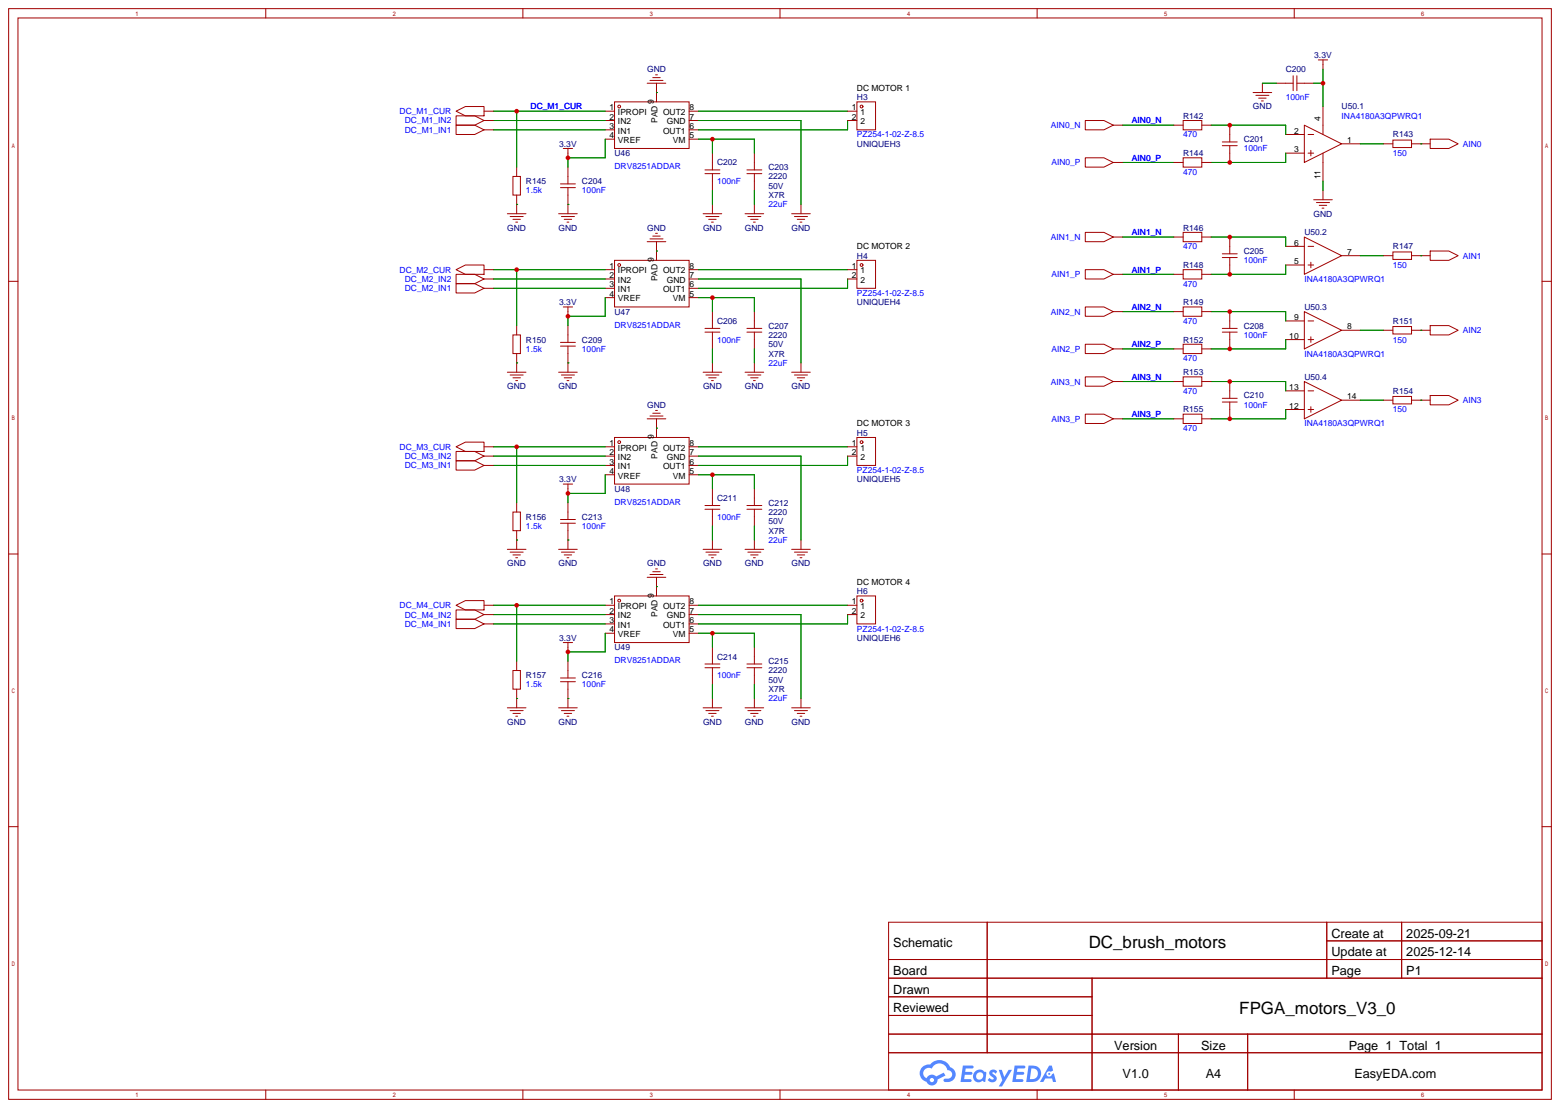
[picture p19: page 4]

Schematic | DC_brush_motors | Create at | 2025-09-21

Update at | 2025-12-14

Board | | Page | P1
Drawn | | FPGA_motors_V3_0
Reviewed

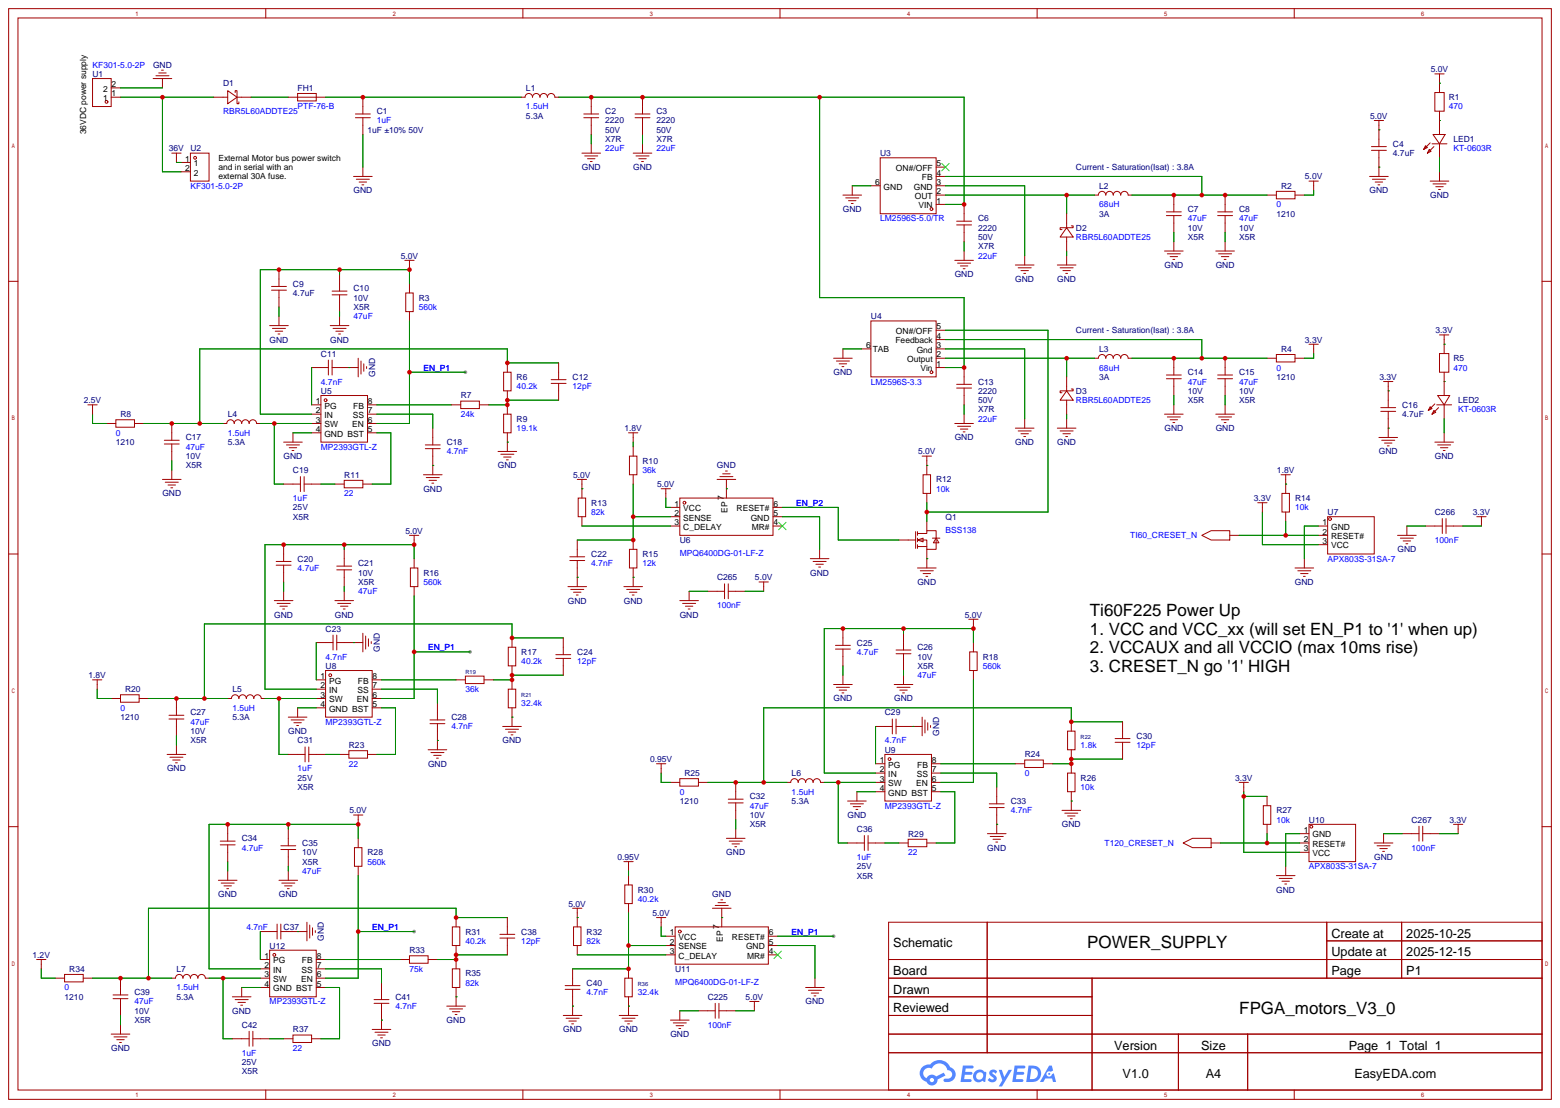
[picture p20: page 5]

External Motor bus power switch

Ti60F225 Power Up
1. VCC and VCC_xx (will set EN_P1 to '1' when up)
2. VCCAUX and all VCCIO (max 10ms rise)
3. CRESET_N go '1' HIGH

Schematic | POWER_SUPPLY | Create at | 2025-10-25

Update at | 2025-12-15

Board | | Page | P1

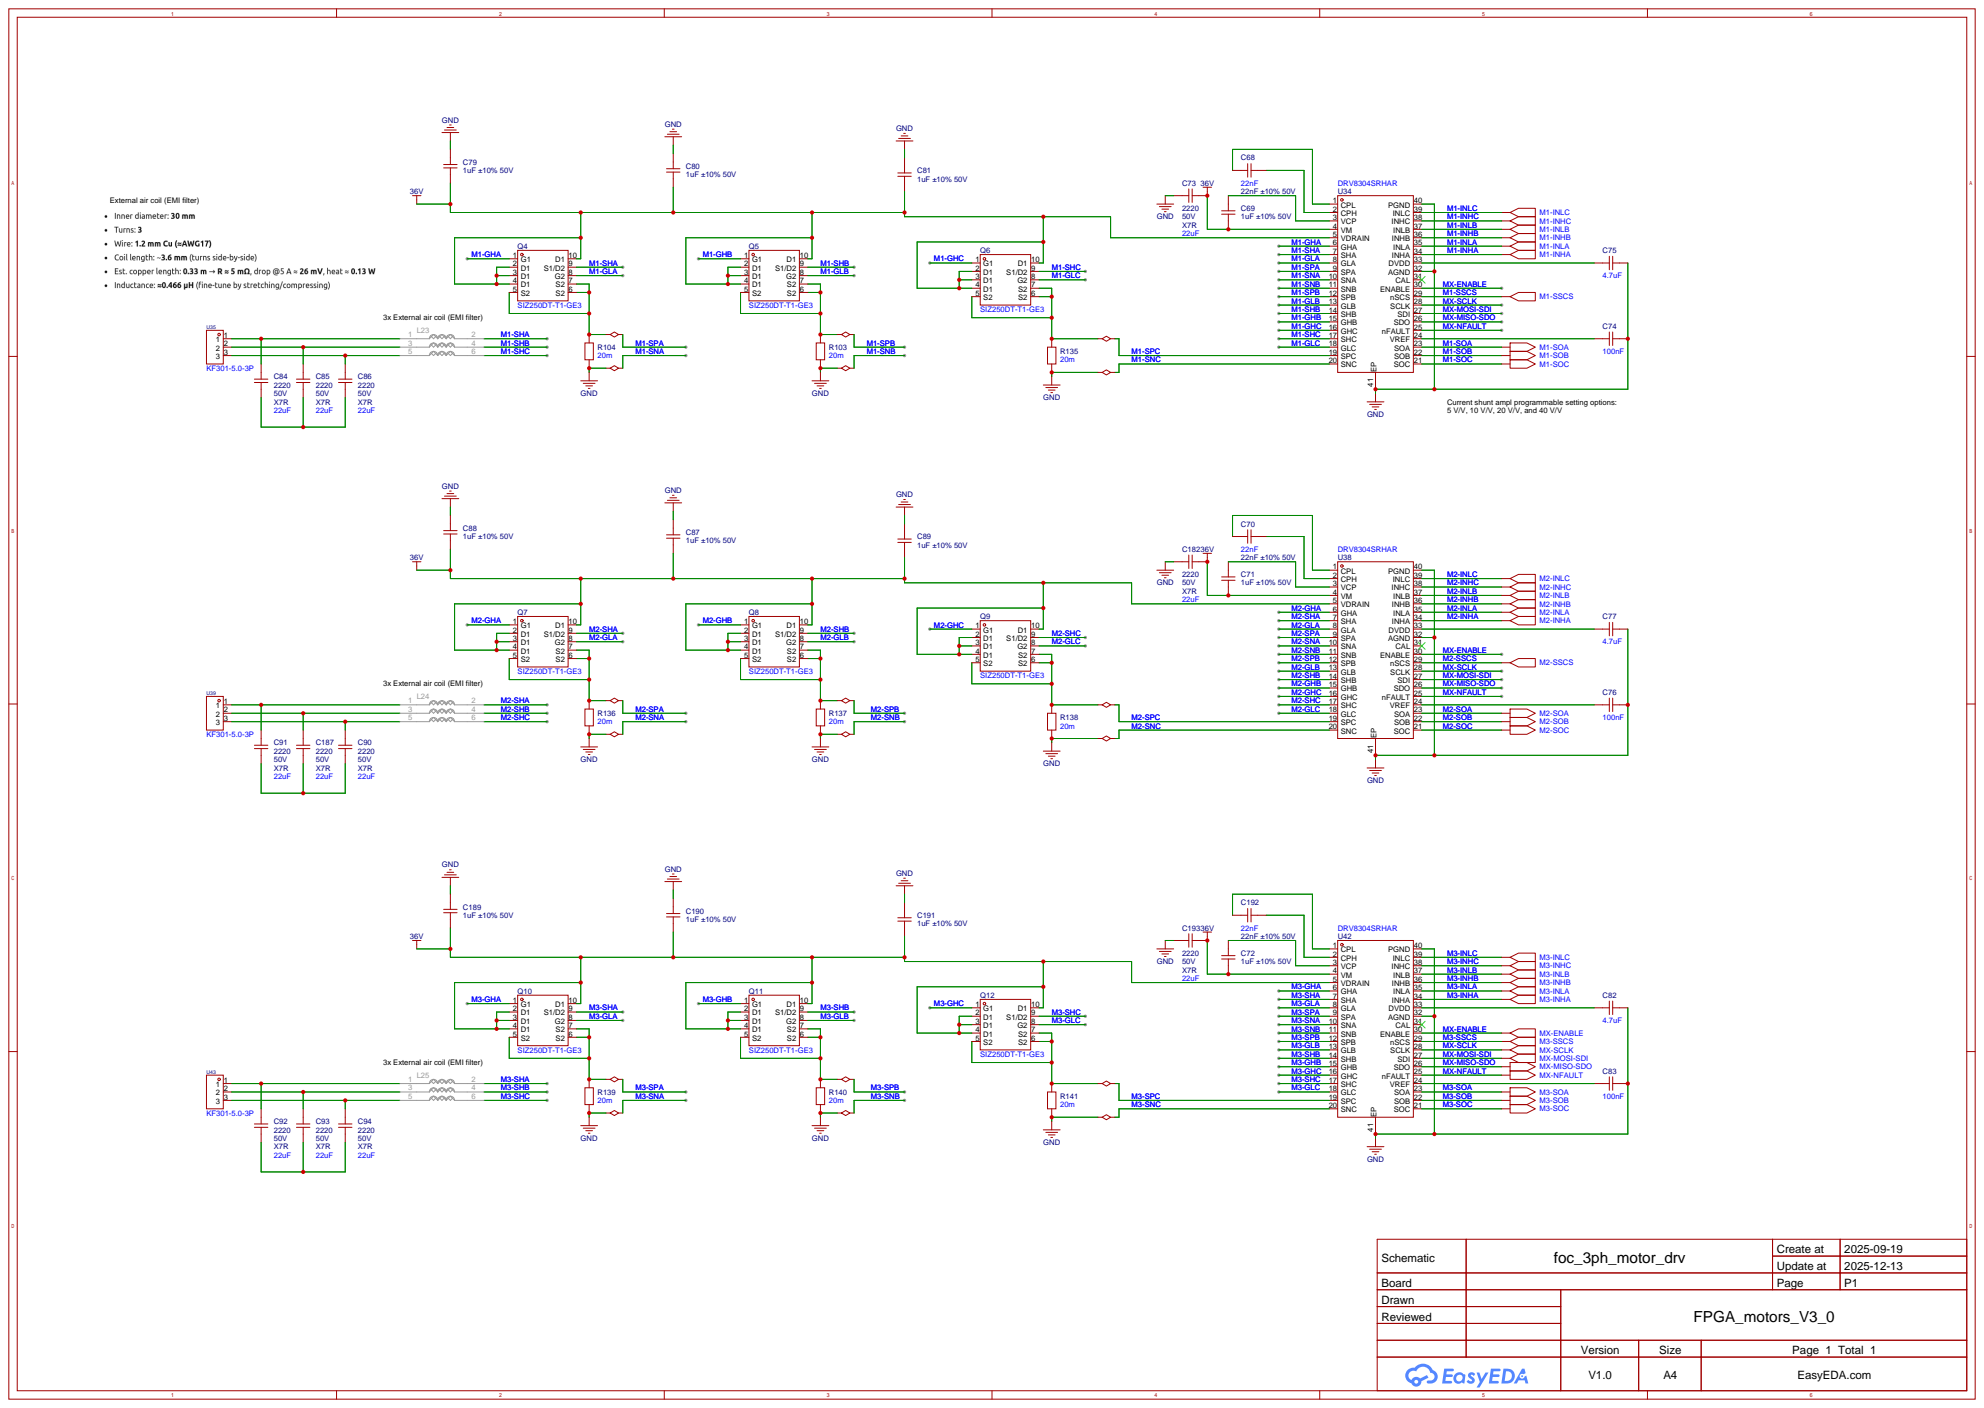
[picture p21: page 6]

External air coil (EMI filter)

3x External air coil (EMI filter)

Current shunt ampl programmable setting options:
5 V/V, 10 V/V, 20 V/V, and 40 V/V

Schematic | foc_3ph_motor_drv | Create at | 2025-09-19

Update at | 2025-12-13

Board | | Page | P1

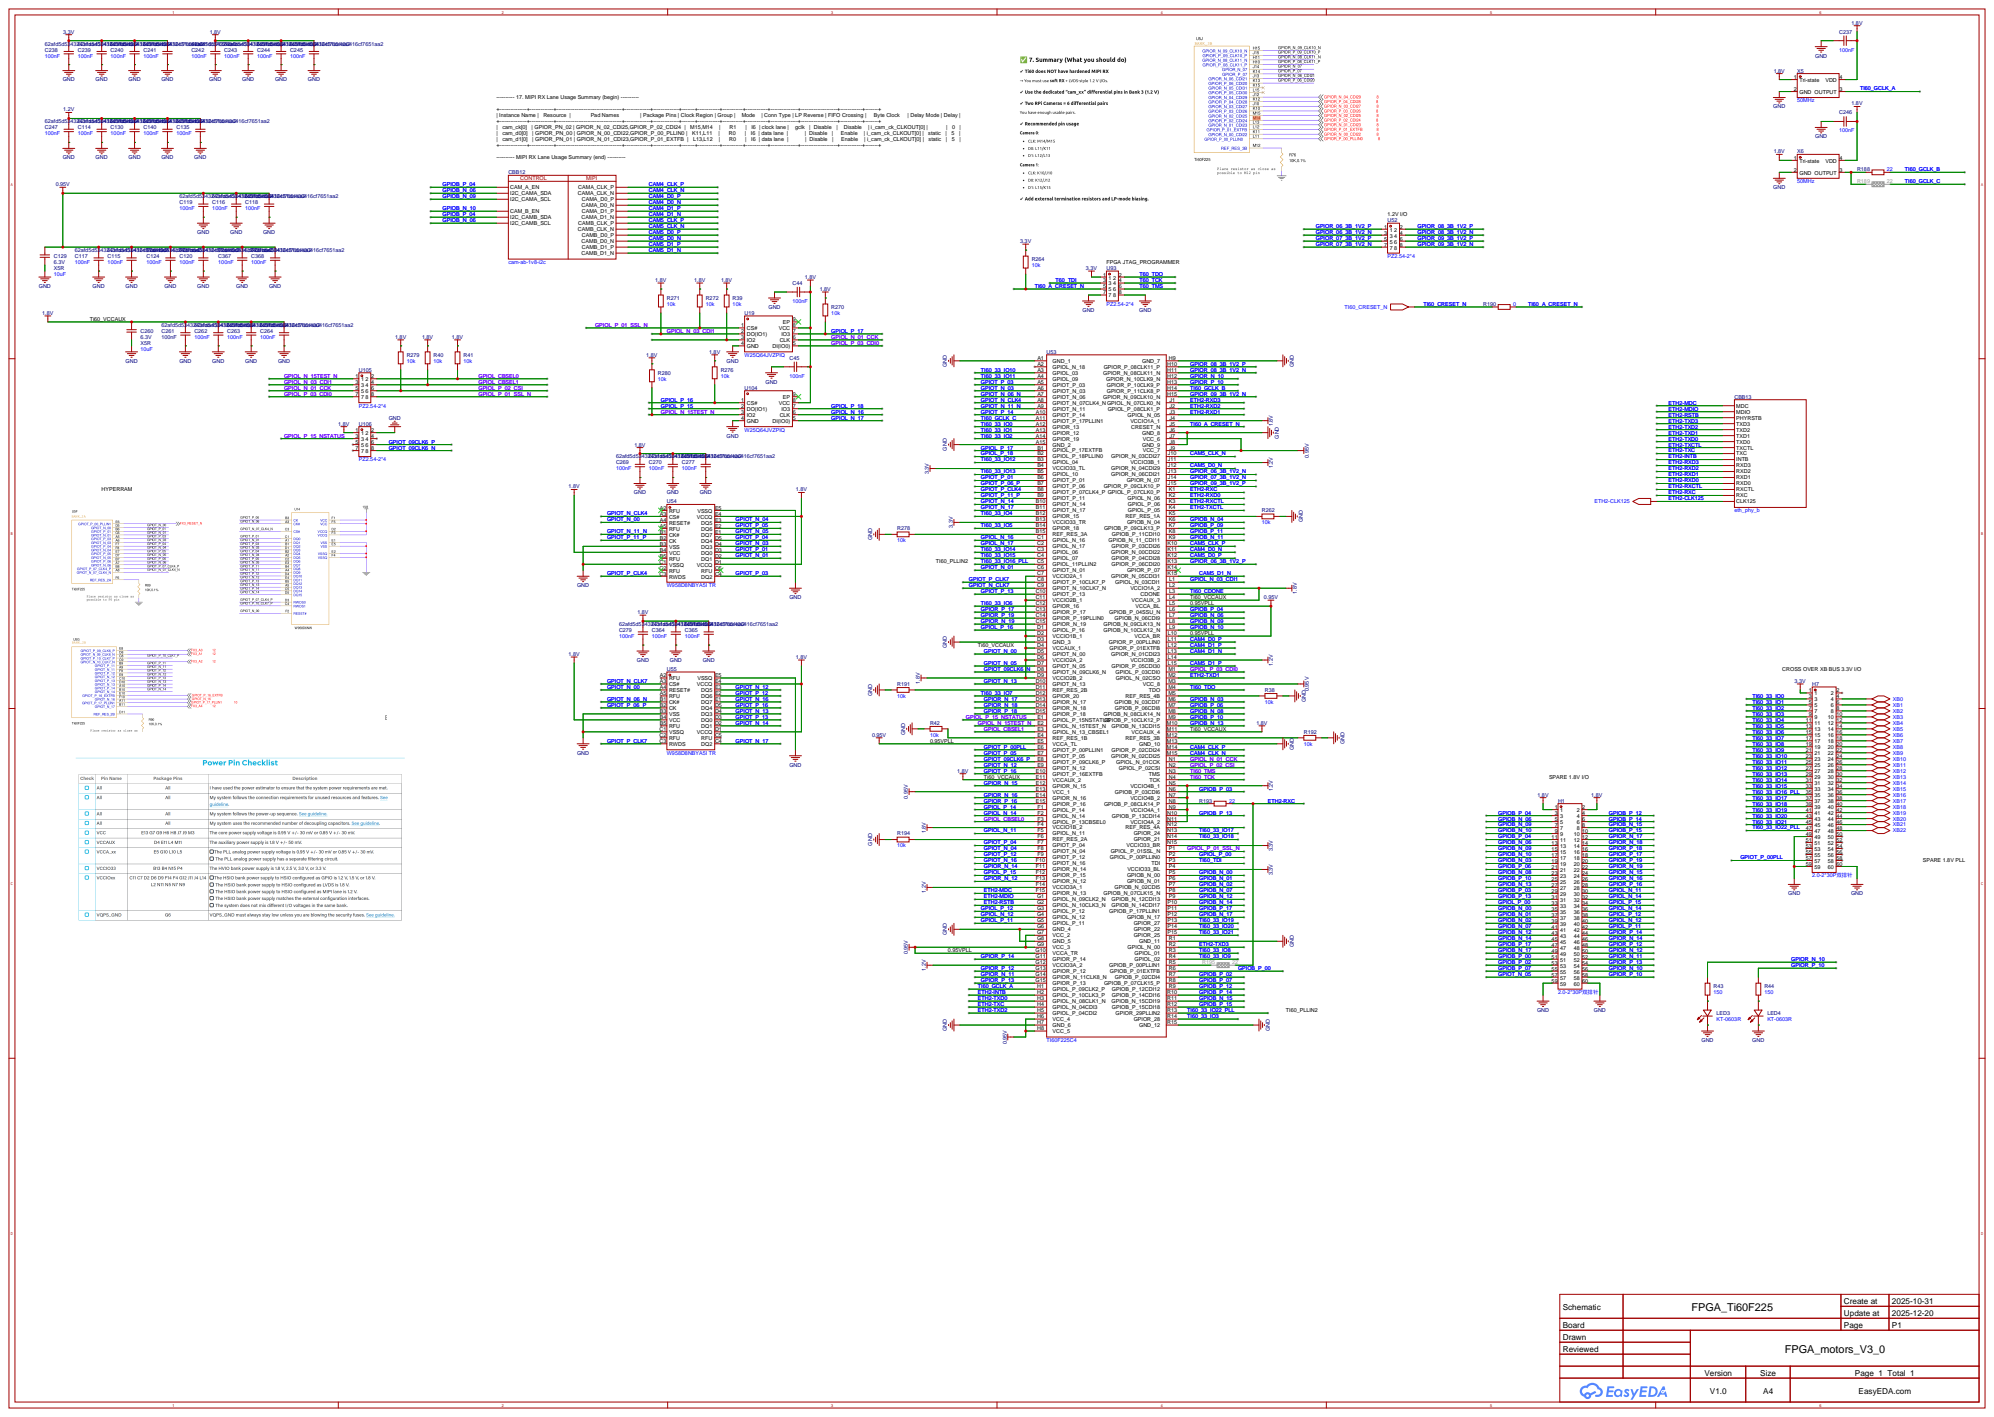
[picture p22: page 7]

---------- 17. MIPI RX Lane Usage Summary (begin) ----------
---------- MIPI RX Lane Usage Summary (end) ----------

GND GND GND GND GND

J7
J8

DQ2 C4 RWDS C3 RFU C2 VSSQ C1 RFU B5 VCC B4 VSS B3 CK B2 CK# B1 RFU A5 RESET# A4 CS# A3 RFU A2

Schematic | FPGA_Ti60F225 | Create at | 2025-10-31

Update at | 2025-12-20

Board | | Page | P1

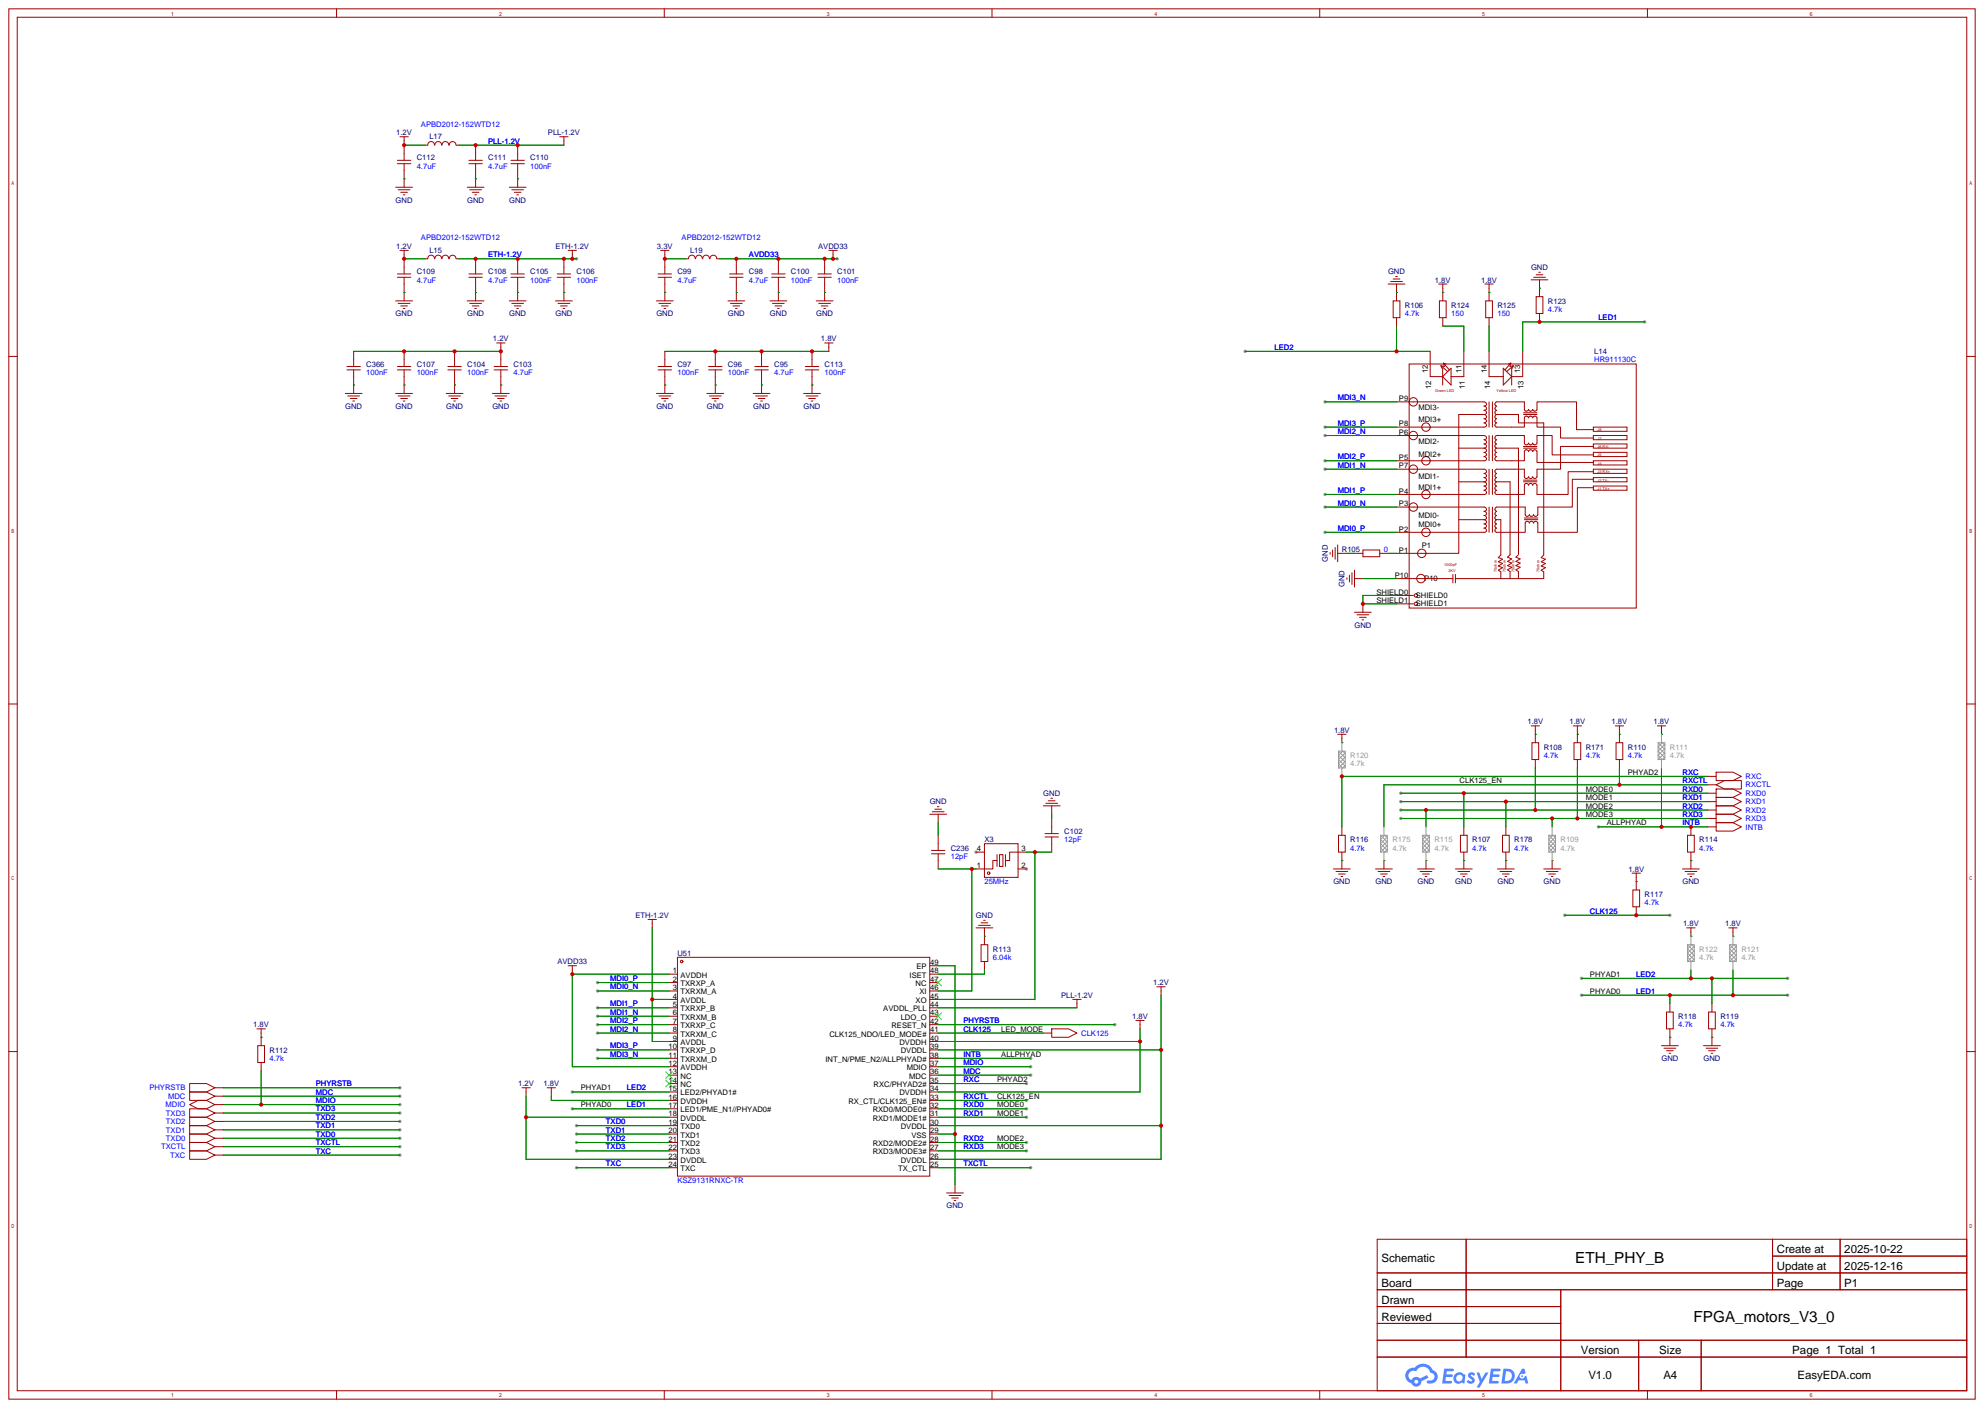
[picture p23: page 8]

Schematic | ETH_PHY_B | Create at | 2025-10-22

Update at | 2025-12-16

Board | | Page | P1

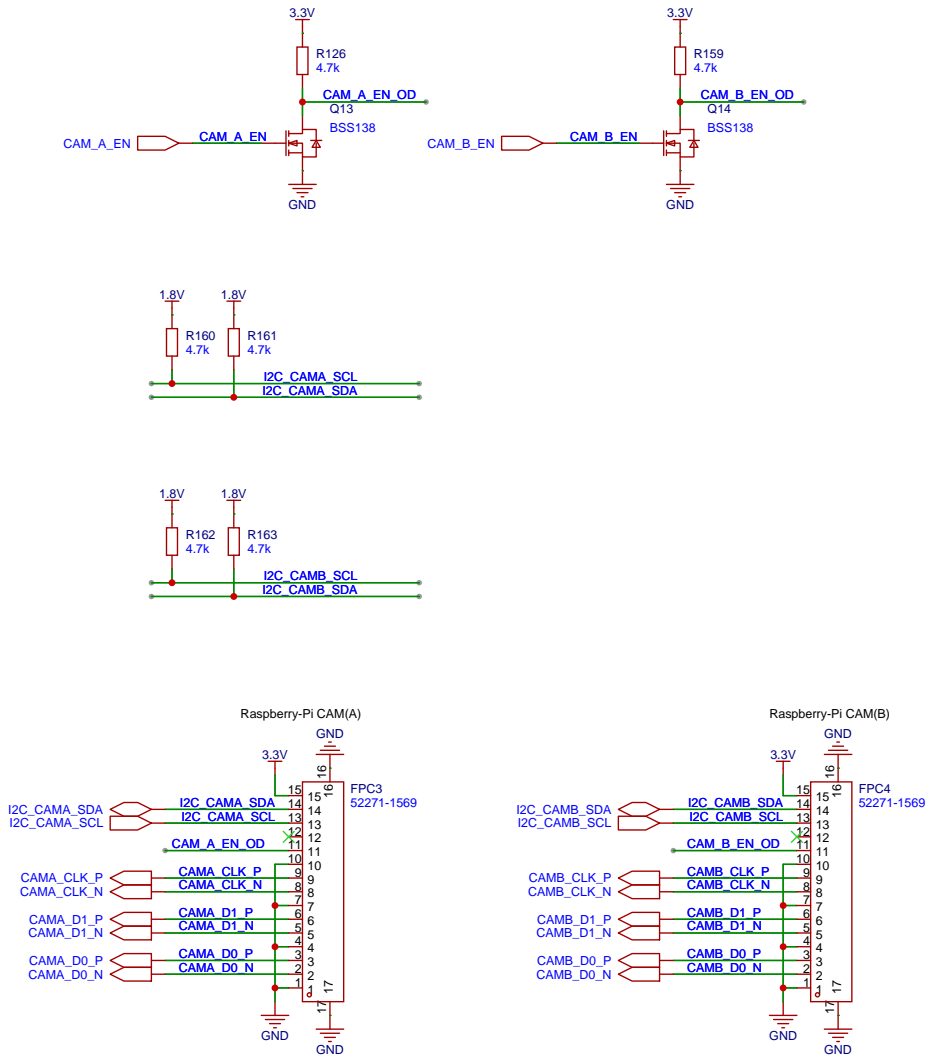
[picture p24: page 9]

Schematic | CAM-AB-1V8-I2C | Create at | 2025-10-25

Update at | 2025-11-13

Board | | Page | P1
Drawn | | FPGA_motors_V3_0
Reviewed

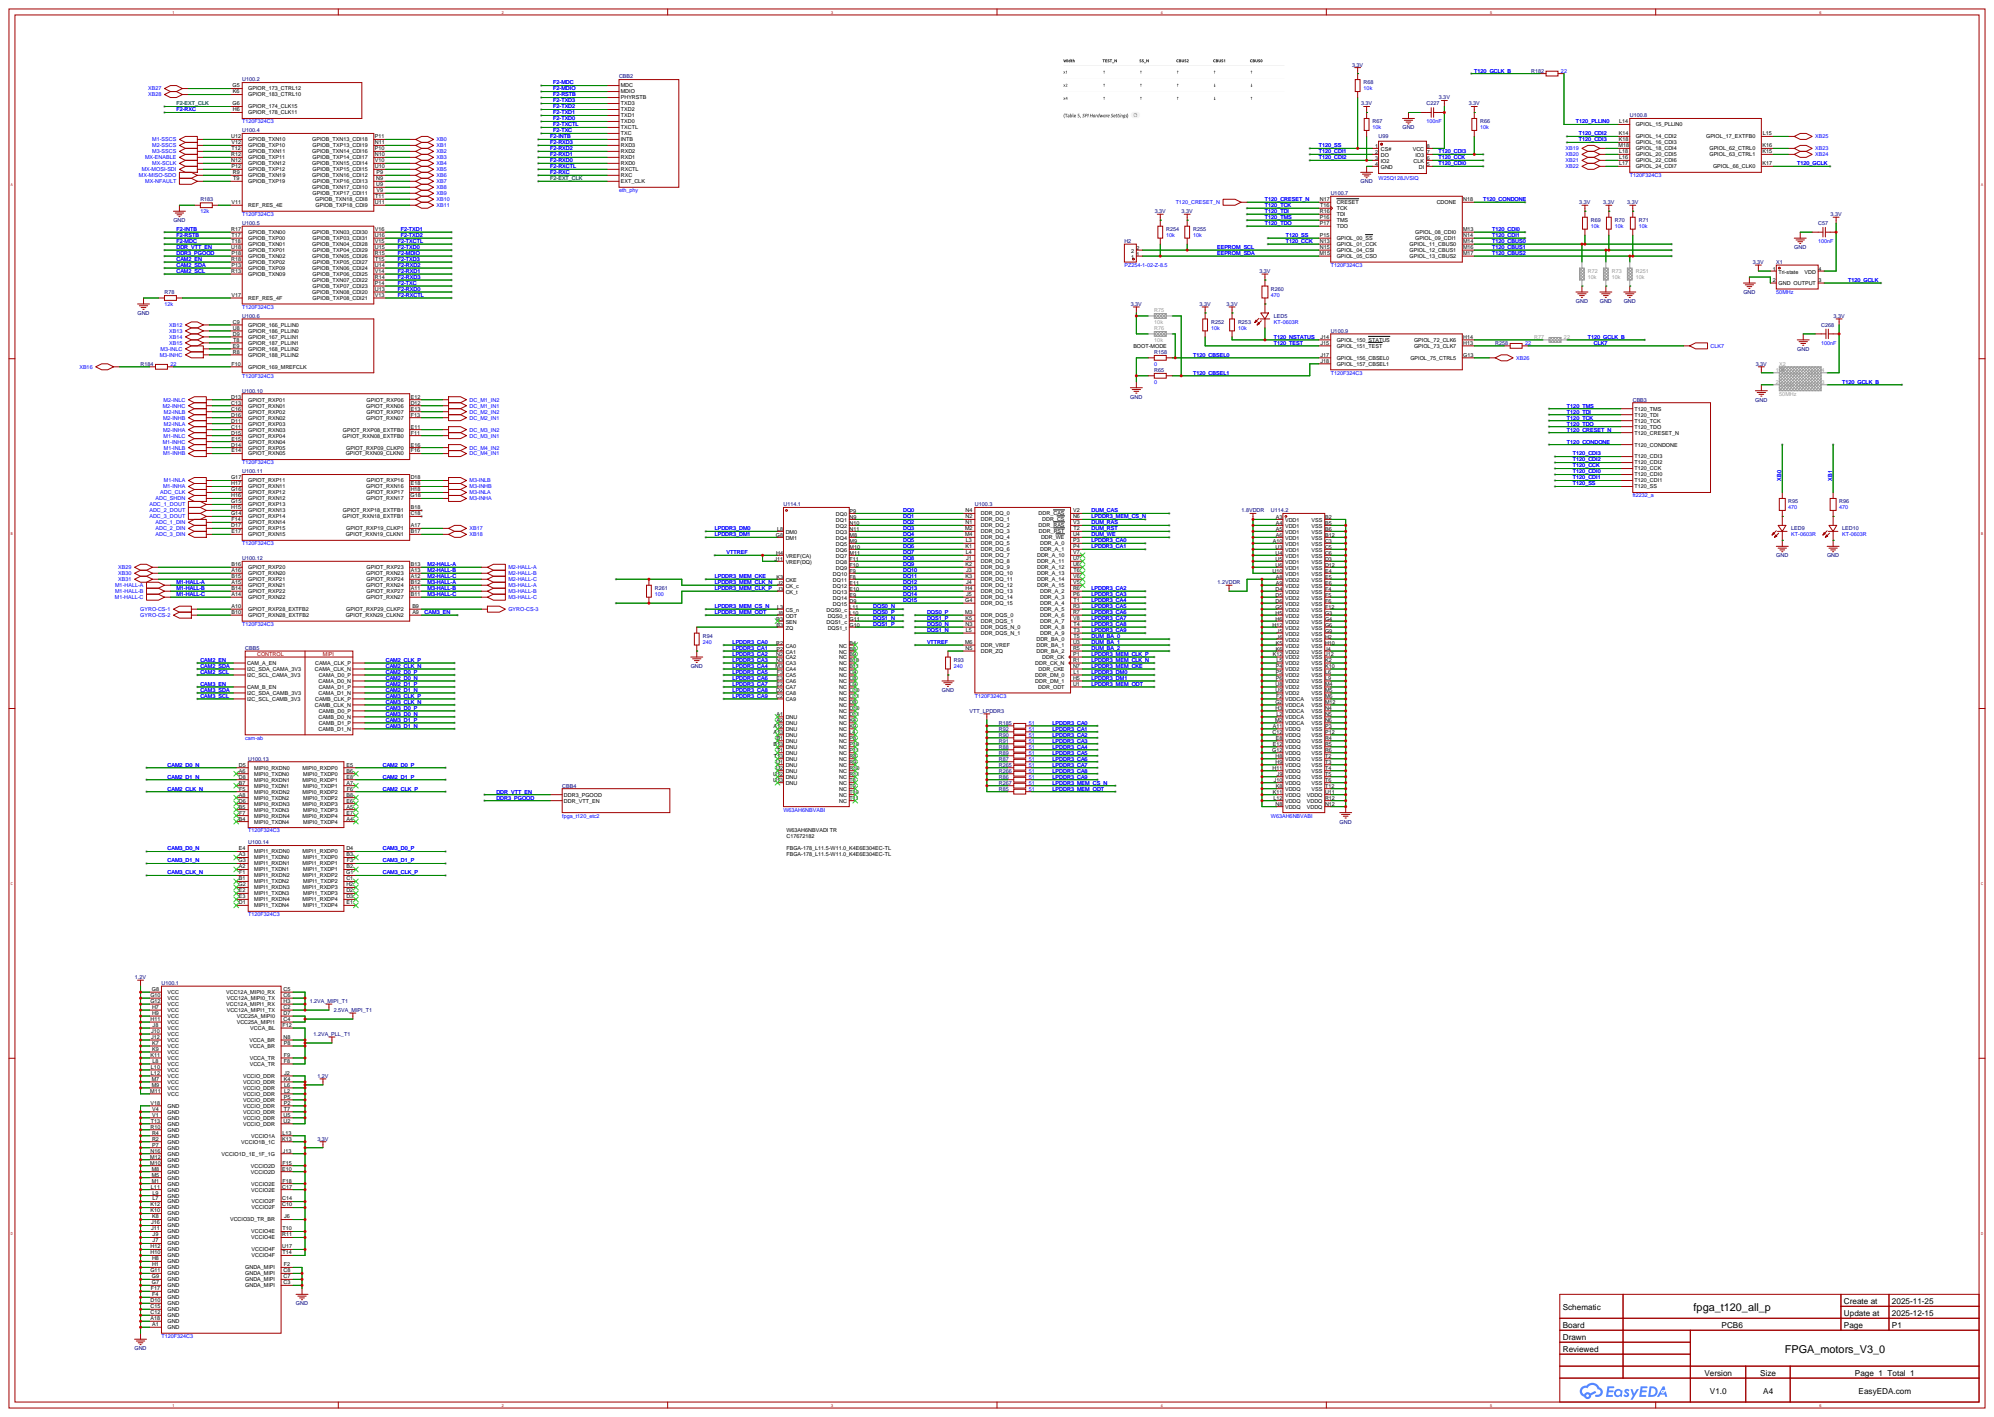
[picture p25: page 10]

Schematic | fpga_t120_all_p | Create at | 2025-11-25

Update at | 2025-12-15

Board | PCB6 | Page | P1

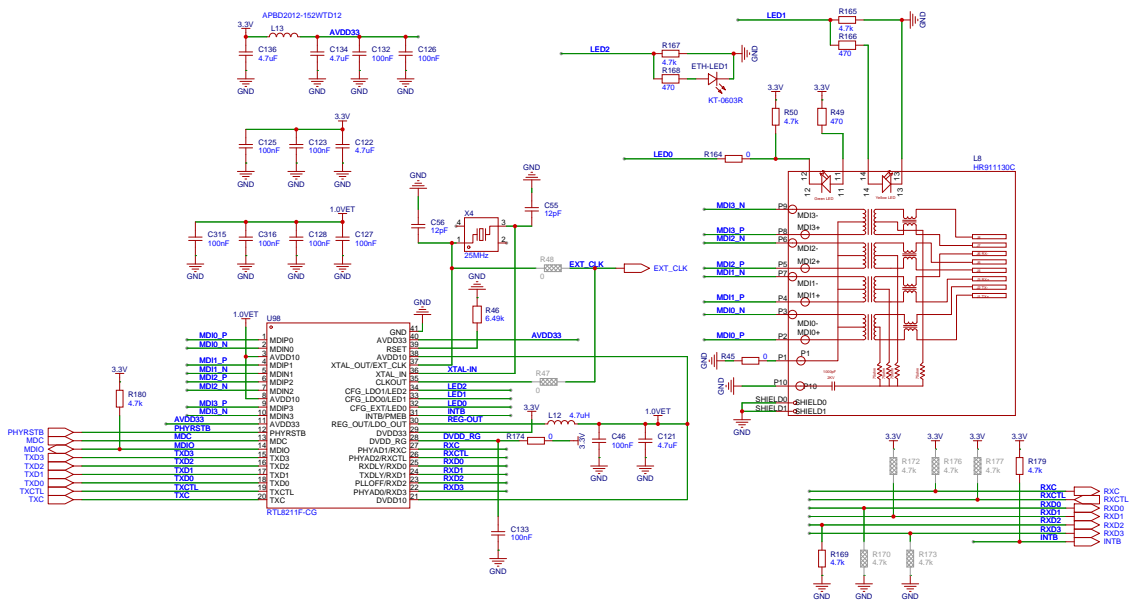
[picture p26: page 11]

Schematic | ETH_PHY | Create at | 2025-09-21

Update at | 2025-12-09

Board | | Page | P1

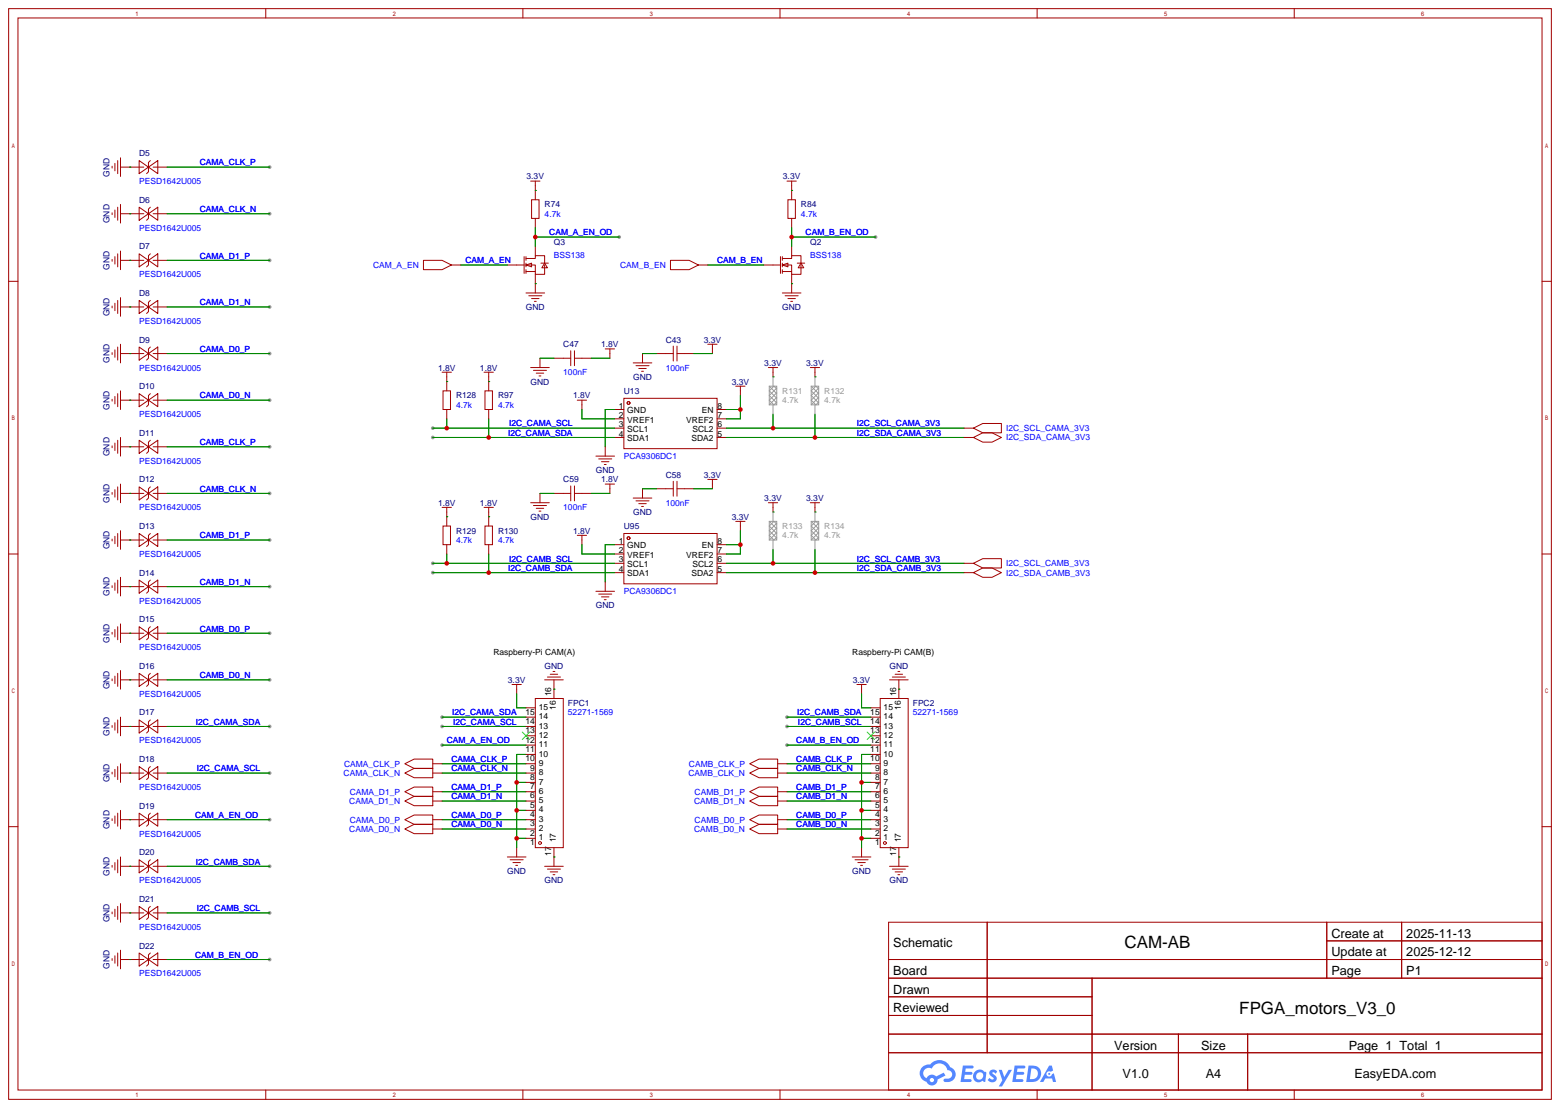
[picture p27: page 12]

Schematic | CAM-AB | Create at | 2025-11-13

Update at | 2025-12-12

Board | | Page | P1
Drawn | | FPGA_motors_V3_0
Reviewed

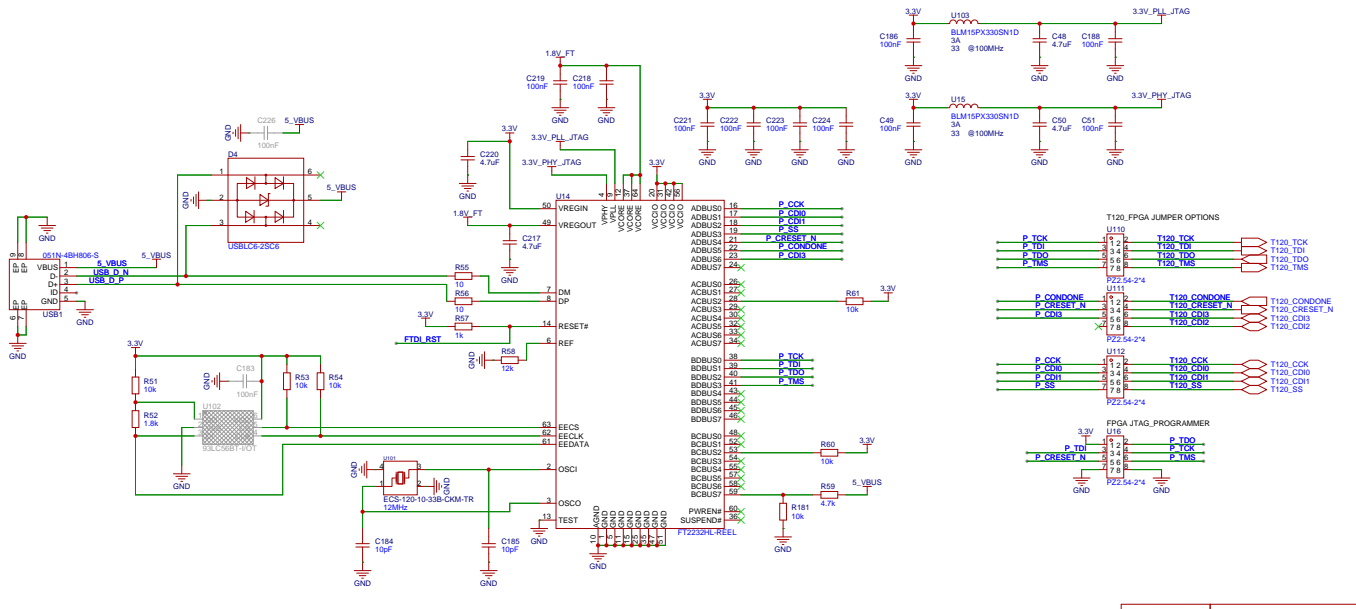
[picture p28: page 13]

Schematic | FT2232_a | Create at | 2025-11-25

Update at | 2025-12-13

Board | | Page | P1

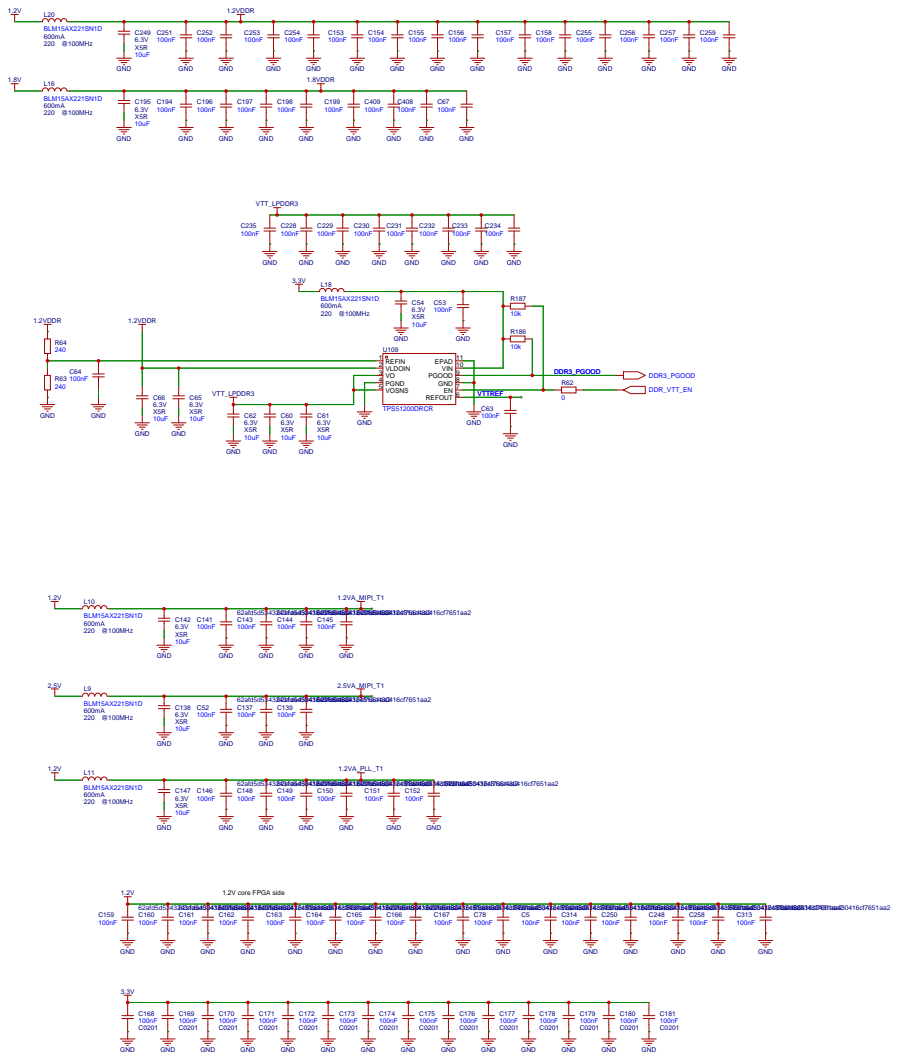
[picture p29: page 14]

Schematic | fpga_t120_etc2 | Create at | 2025-11-25

Update at | 2025-12-07

Board | | Page | P1

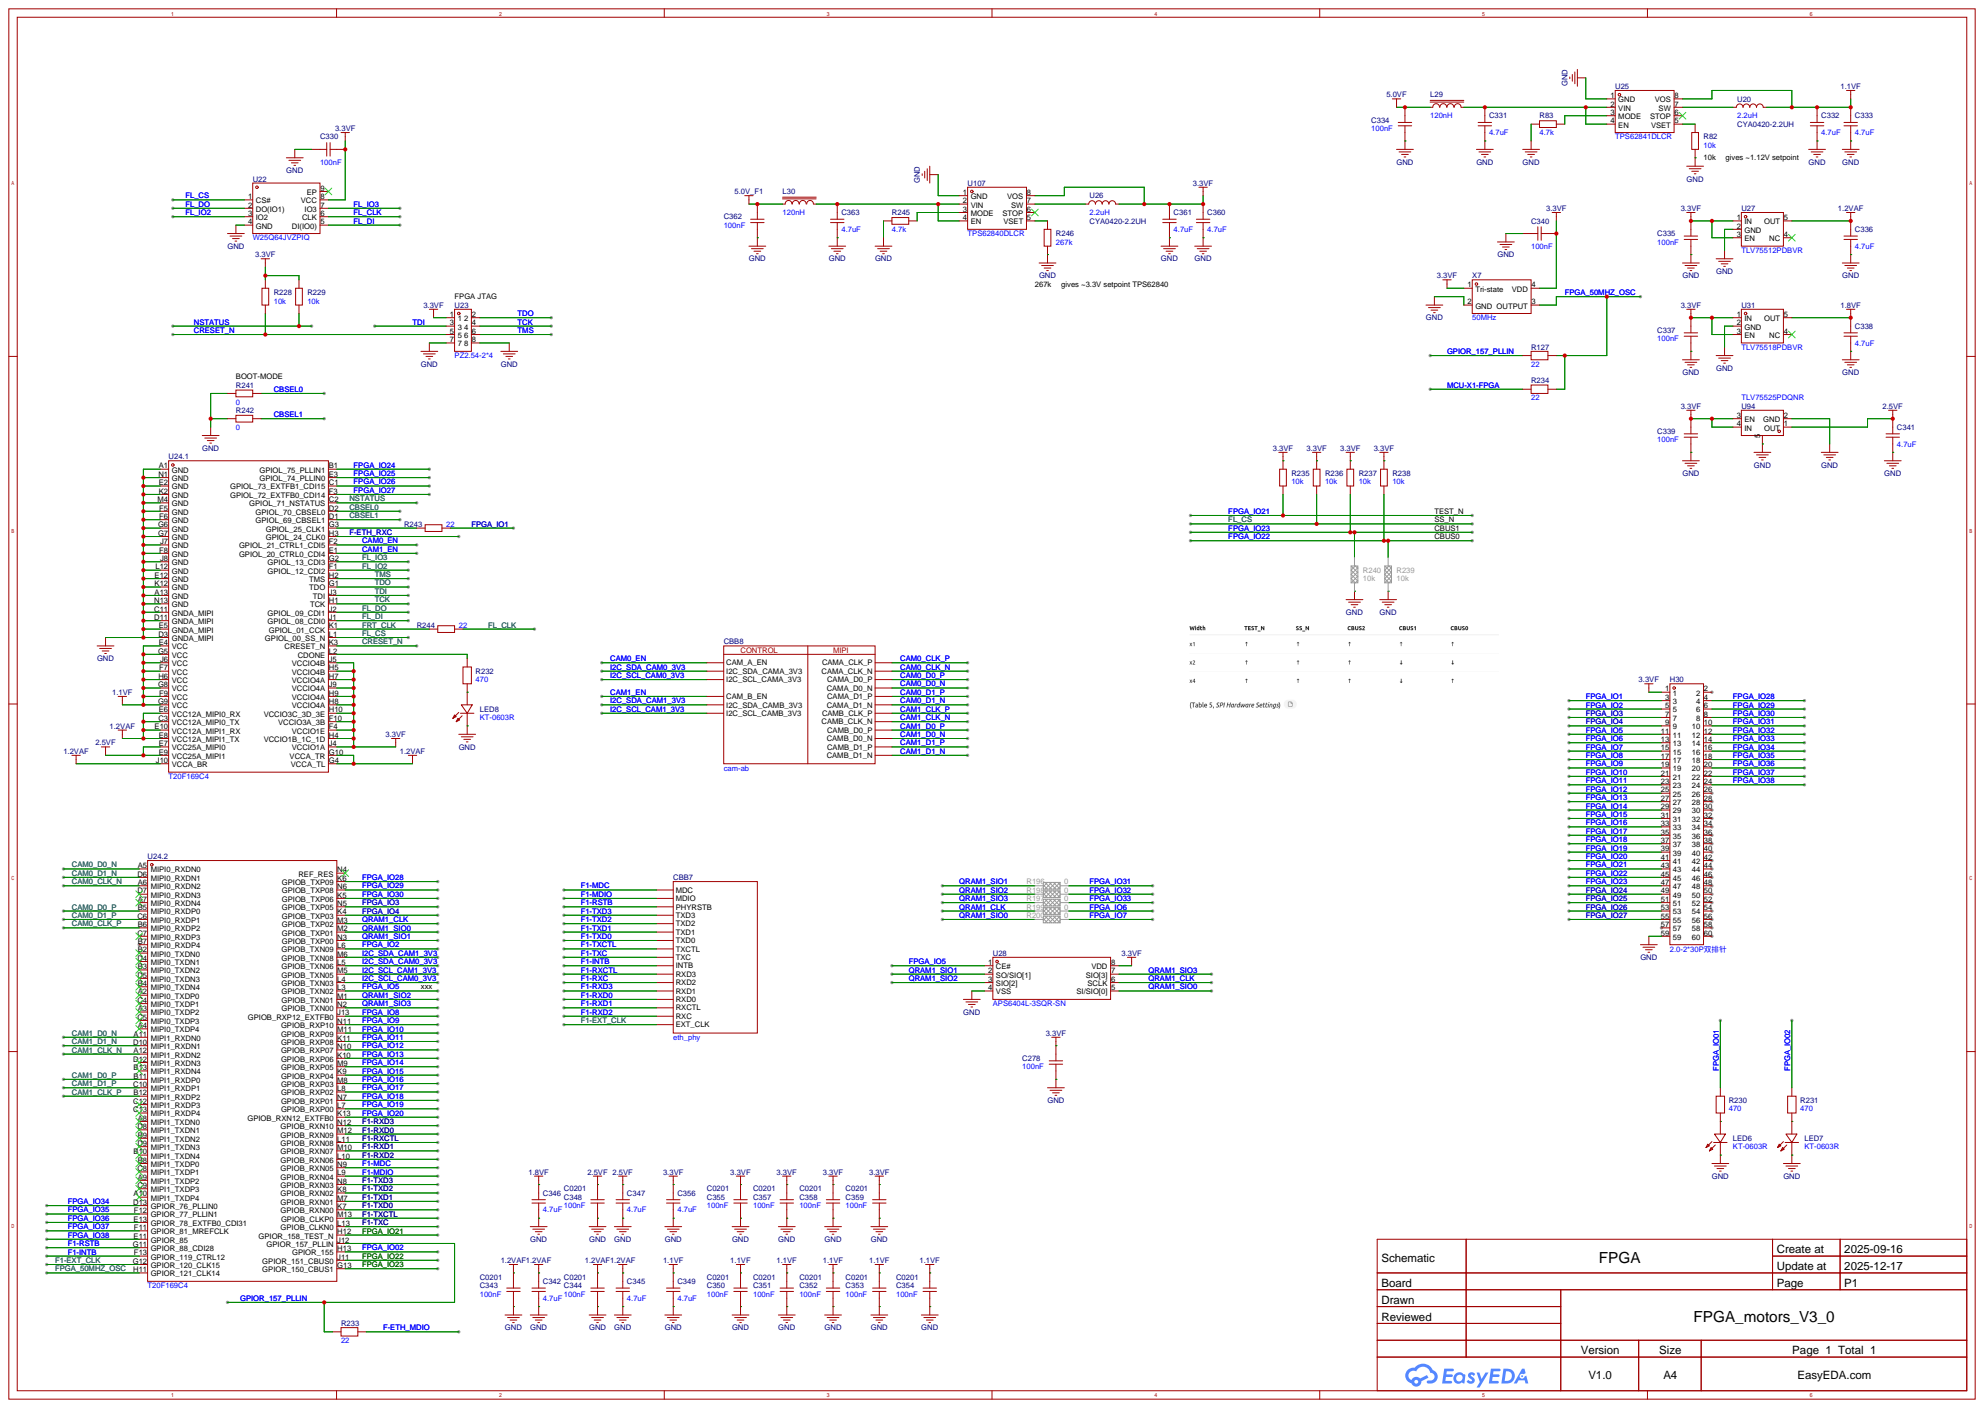
[picture p30: page 15]

Schematic | FPGA | Create at | 2025-09-16

Update at | 2025-12-17

Board | | Page | P1

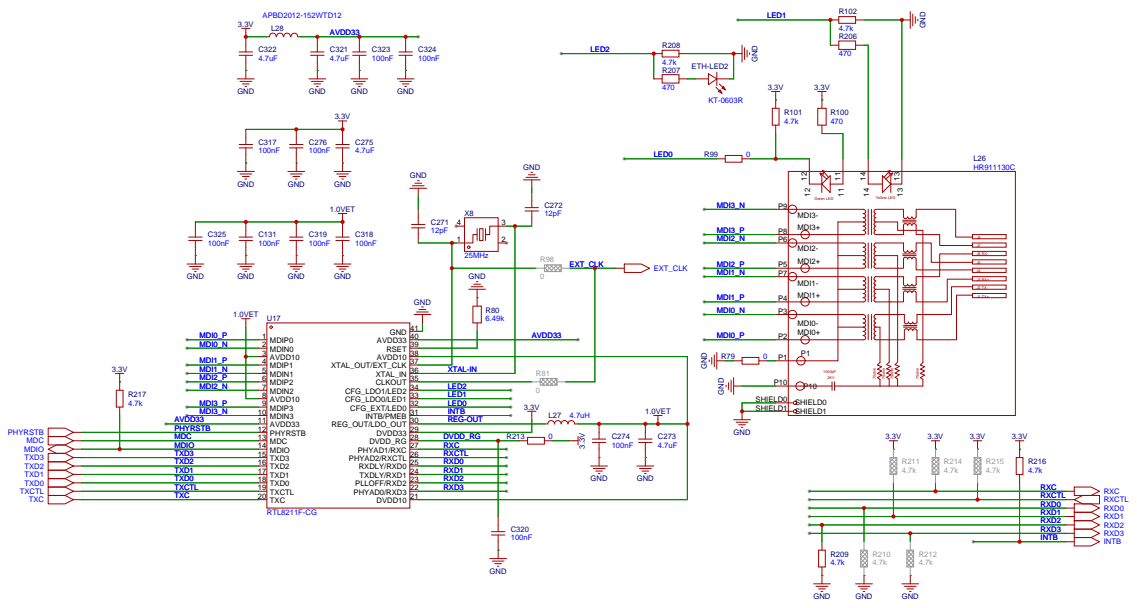
[picture p31: page 16]

Schematic | ETH_PHY | Create at | 2025-09-21

Update at | 2025-12-09

Board | | Page | P1

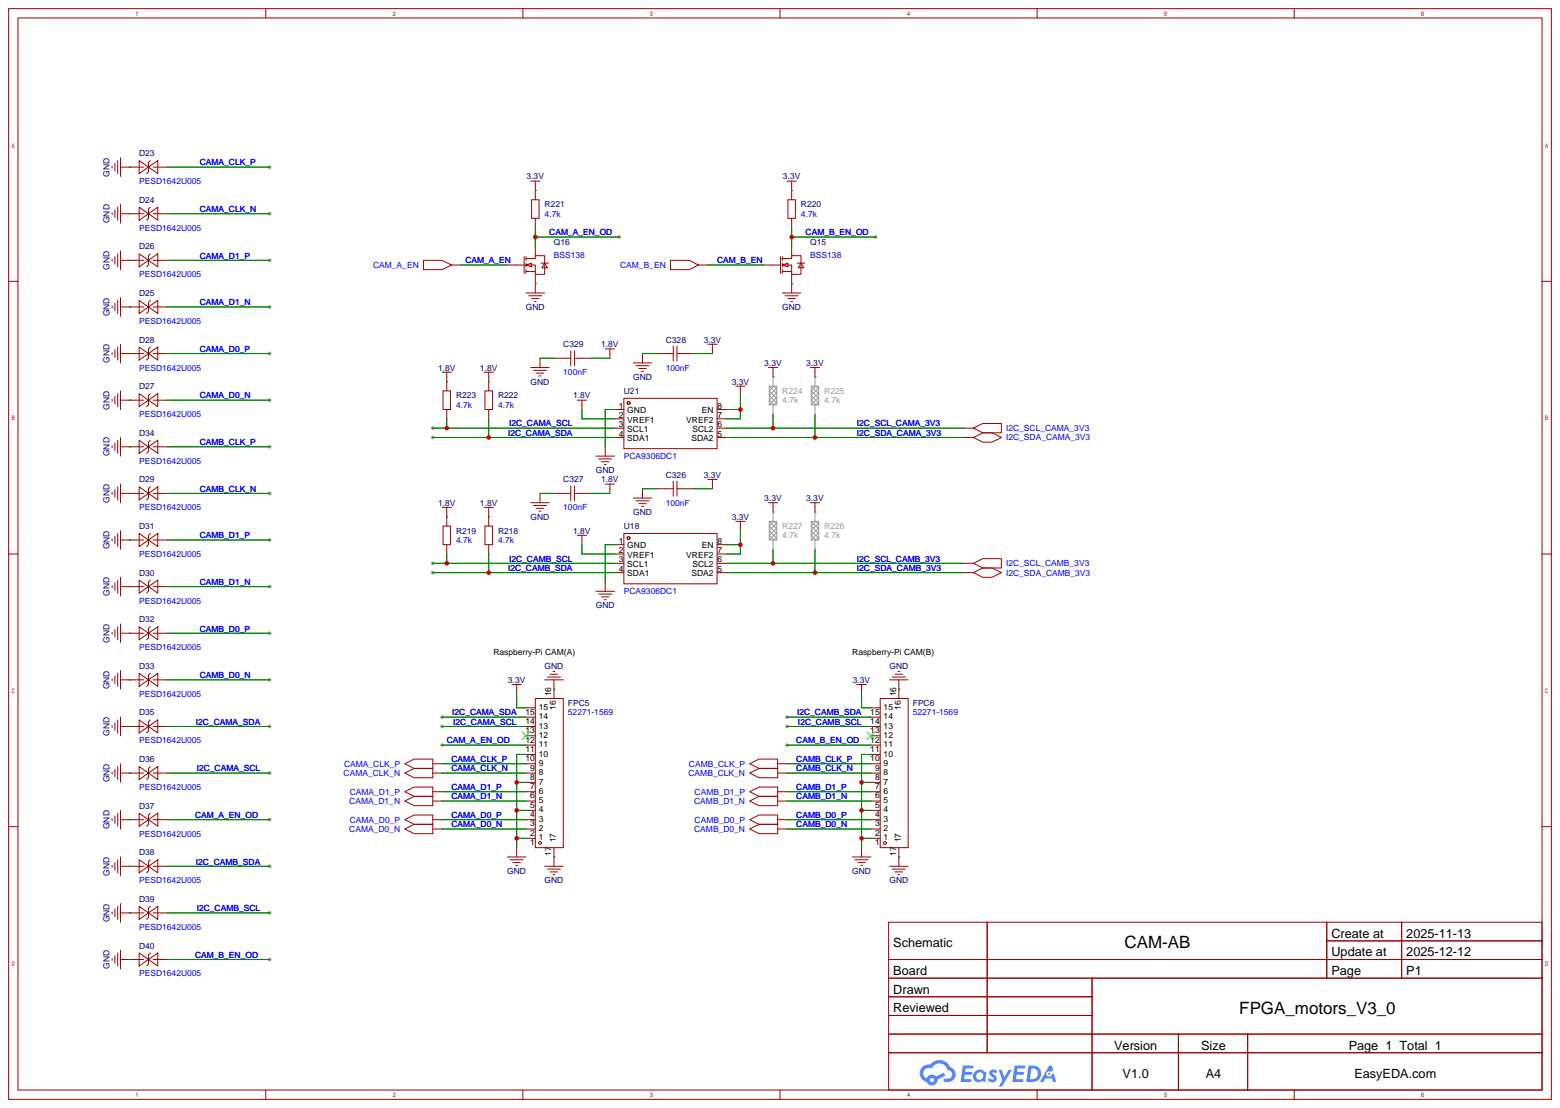
[picture p32: page 17]

Schematic | CAM-AB | Create at | 2025-11-13

Update at | 2025-12-12

Board | | Page | P1
Drawn | | FPGA_motors_V3_0
Reviewed
