ollewelin/delta_robot/(list of files, drawings)

Other design files:
ProPrj_3x3motorFPGA_V2_1_2025-08-15.epro
V2.0_PCBA_manufacture_export/ProPrj_3x3motorFPGA_2025-07-05.epro
